Autonomous-Robotics-Carleton/arc-monorepo/firmware/README.md

# firmware

Code that runs on the car's microcontrollers.

| Folder | Target | RTOS | Decided in |
| --- | --- | --- | --- |
| `sync-mcu/` | STM32H723 on the sync board: time base, sensor timestamping, camera triggers, watchdog, safety envelope, the command and steering CAN buses, a telemetry UART from each motor controller, Ethernet to the Orin | Zephyr | ADR-0017, ADR-0021, ADR-0034 |
| `vesc/` | The four A50S motor controllers: stock VESC firmware plus the e-stop brake routine, UART telemetry and a speed limit | ChibiOS | ADR-0012, ADR-0033, ADR-0034 |

The steering controller (moteus-c1) runs mjbots' firmware, not ours. Its configuration (timeout mode, limits, belt ratio) will be kept here too (ADR-0019).

Safety functions live only on the sync MCU and the VESCs, never on the Orin (ADR-0017). Changes to them get extra review.

Each firmware builds for simulation, development hardware and the car from the same source (ADR-0028). For the VESC firmware, simulation means host unit tests of our additions, and development hardware is a spare A50S on stock firmware; the toolchains come in the dev container (ADR-0029). How it all fits: `systems/software/architecture.md`; what's being set up and in what order: `systems/software/setup-plan.md`.
