Autonomous-Robotics-Carleton/arc-monorepo/firmware/vesc/README.md

# vesc

Firmware for the four motor controllers: off-the-shelf Team Triforce A50S V2.3c boards on the lower deck (ADR-0034), built from upstream's `a50s_v23c_12s` target. Flash it with VESC Tool over USB; per-unit current calibration lives in the board's EEPROM and survives reflashing.

It's stock VESC firmware plus four additions:

- **E-stop brake routine** (ADR-0012, ICD-corner-connector): reads ESTOP on the Servo/PPM pin (PB6) with the MCU's pull-down, so an open line is an e-stop. While ESTOP is low it ignores every motor command (CAN, USB, apps), ramps brake current from 0 to the target over 150 ms (TBC) and holds it; the target, ~8 A (TBC), is worked out from the 5 m/s² deceleration (TBC, ADR-0052) and the car's mass, tyre, gearing and motor kV, all named constants in `arc/include/arc/estop.h`. Releasing ESTOP doesn't restart motion: the brake stays on until a fresh command arrives. The logic is in `arc/src/estop.c` with host tests; `arc/port/estop_vesc.c` runs it every millisecond on the controller. The PPM app and servo output must stay off (the routine takes the pin back if they claim it), and on the bench ESTOP has to be held high to drive or run motor detection. This is a safety function: it needs its own test cases, and every change gets a second reviewer. **Not safe on its own yet:** "a fresh command hands back control" relies on the sync MCU latching on every e-stop press and resuming only after the release, its power-on checks and the operator's re-arm, with zero commands first (owner decision; its ADR is in draft). That latch isn't implemented yet, so until it is, releasing ESTOP on a bench rig lets the motor resume on the next command it receives: bench-test with the wheel off the ground and the command source at zero.
- **Command timeout** (ADR-0035): no command for 150 ms (TBC) while driving brakes on the same ramp as the e-stop, ignoring commands until a fresh one arrives; a press takes over at any time. It replaces upstream's timeout (1000 ms, then 0 A: coasting), which can't act while the routine brakes. A command is anything that resets upstream's timeout: CAN on the car, and on a bench also USB and VESC Tool's keepalive, which keep the motor out of the timeout. Part of the e-stop routine (`arc/src/estop.c`), so the same safety function: `arc_estop_command_timeout()` is the `COMMAND_TIMEOUT` bit for the telemetry.
- **UART telemetry** (ADR-0024, ADR-0034, ICD-controller-telemetry): MAVLink 2 `ARC_MOTOR_STATUS` at 1 kHz, including a `state` field that reports braking on e-stop or command timeout (ADR-0035), and `ARC_LINK_STATUS` at 1 Hz (message set in `systems/icd/sync-link.xml`), on the A50S's UART (USART3, PB10/PB11) to the sync MCU at 2 Mbit/s (exact with 16× oversampling from its 42 MHz clock); motor commands stay on the classic CAN bus. Each frame is built from the latest motor-control values at send time, with `time_ns` in the controller's clock. The telemetry thread runs at high thread priority; motor control runs in the ADC interrupt, which preempts every thread, and RSK-12 tracks what's left of the risk. UART transfers are to be DMA-driven, which needs upstream's serial driver off USART3. The MAVLink code isn't generated into this firmware yet.
- **Speed limit** (ADR-0034): maximum eRPM ~75k (TBC), which keeps ≥ 10 control-loop samples per electrical cycle; stability up to it is checked on rig R2 (RSK-18). The firmware clamps the configured eRPM limits to it on every configuration change and timer tick, whatever VESC Tool or a configuration message sets. Upstream's eRPM limit is soft: it cuts back the motor current as the motor approaches the limit and truncates speed-mode setpoints. It doesn't brake, so it can't stop overspeed driven from outside (rolling downhill, being pushed). The bench sweep on rig R2 confirms how the motor behaves at the limit (RSK-18).

**Don't touch the USB, CAN or firmware-upload code.** The running firmware receives uploads, so a build that breaks them can only be recovered over SWD (RSK-20).

## Upstream and updates (ADR-0033)

Upstream `vedderb/bldc` is vendored into `bldc/` as a plain snapshot, at `release_7_00` (SQ-3). `UPSTREAM` records the repository, ref and commit it's based on. Our additions are modules in `arc/`; `bldc/` carries only the ordinary commits that join them to the build (ADR-0037): one line in `make/fw.mk` that includes `arc/arc.mk`, and the call sites, each marked with an `ARC` comment.

```bash
tools/vesc-upstream.sh import <ref>   # first import: done, at release_7_00 (SQ-3)
tools/vesc-upstream.sh update <ref>   # bring in upstream's changes, three-way, in a PR of its own
```

The script stages its result but doesn't commit it; on conflicts it lists the files and exits 2. It skips lispBM's tests, test reports, REPL, docs, examples, benchmarks, videos and mascot on every import and update. `VESC_UPSTREAM_URL` overrides the upstream repository.

**Licence:** everything under `firmware/vesc/` is GPL-3.0, under upstream's licence; the rest of the repo is MIT. Don't copy code from here into other parts of the repo.

## Layout

| Path | What |
| --- | --- |
| `bldc/` | Upstream VESC firmware, plus the hooks that join `arc/` to the build (marked `ARC`) |
| `arc/` | Our additions (e-stop and command timeout, UART telemetry, speed limit) as modules with host tests; `arc.mk` joins them to the firmware build. A module not implemented yet is a fail-safe stub |
| `UPSTREAM` | The upstream commit `bldc/` is based on |
| `motors/` | Each drive motor's detected configuration, by the label on the motor, and how to load it with VESC Tool after a corner swap (SYS-13) |

## Build and test

In the dev container (GCC 7 2018-q2, the compiler upstream expects):

```bash
npx nx build vesc   # bldc: make fw_a50s_v23c_12s -> bldc/build/a50s_v23c_12s/*.bin
npx nx test vesc    # arc/: host tests with CMake and CTest, then the coverage check
```

The host tests run under AddressSanitizer and UndefinedBehaviorSanitizer, so a memory error or undefined behaviour fails a test even when the value it checks comes out right (`-DARC_SANITIZE=OFF` to build without). They then run again instrumented for coverage, and `nx test vesc` fails unless every line and branch in `arc/src/` runs (proposed in #159, pending the team's minimum). The firmware hooks in `bldc/` aren't host code, so they aren't counted; the hook tests check they're still in place.

Upstream's Makefile warns that the ARM SDK isn't in `bldc/tools`: ignore it. The container's GCC is on `PATH`; don't run `make arm_sdk_install`, which downloads a second copy.

Flash the `.bin` with VESC Tool over USB, following [the flashing procedure](../../systems/tests/a50s-flashing.md): one controller at a time, with the configuration backed up and the e-stop checked again after each, and how to recover a controller over SWD.
