Autonomous-Robotics-Carleton/arc-monorepo/systems/architecture.md

# ARC 4WD Car: Architecture Overview (v1)

Rewritten 2026-10-03 from the original interface spec (Sep 23, 2026, @shrikar vempati). This is the narrative overview. The decisions and numbers live in `requirements/`, `adr/`, `icd/`, `bom/` and `budgets/`; where this page and those disagree, those win. The diagram version is the topology page (`topology.html`).

## What the car is

A 1/10-scale 4WD autonomy research platform: a sandbox where the team's engineers try ideas in software without building hardware first. Classical pipelines come first (state estimation, localization, planning, MPC), then learned and embodied-AI policies (VLAs). Hardware should never be the reason an experiment fails, and should never limit what software can try. Every sensor runs at its full useful rate, timestamped and logged (SYS-24). The accepted limits on v1 hardware are listed in `requirements/system.md`.

v1 is tightly integrated; modular hardware is a v2 goal. The car runs on an indoor school floor and is sized to the F1TENTH/Roboracer box (width 238–341 mm, length 454–654 mm), without following their single-motor, power-equivalence or head-to-head rules.

| Area | v1 | Decided in |
| --- | --- | --- |
| Drive | 4× Castle 1010-4400kV, one per wheel, two-stage gearbox, CVDs | ADR-0026 |
| Motor control | 4× A50S V2.3c (off the shelf, VESC firmware) on the lower deck | ADR-0034 |
| Steering | Gimbal brushless motor + belt, driven by a moteus-c1 | ADR-0019 |
| Compute | Jetson Orin NX 16GB on a fork of Antmicro's baseboard (v1.0: Orin Nano Super developer kit); JetPack 7.2.1, ROS 2 Jazzy | ADR-0010, ADR-0016, ADR-0025, ADR-0046 |
| Sync and sensor hub | STM32H723 on Zephyr: owns the time base, safety envelope and watchdog | ADR-0011, ADR-0017, ADR-0021, ADR-0034 |
| Power | 4S LiPo; power board with LV rails, monitoring and e-stop circuit; bus clamp | ADR-0012, `budgets/power-scenarios.md` |
| Ground link | Team router (GL.iNet Flint 3, 6 GHz), laptop gateway, button hotspot, service port | ADR-0015 |

**Builds (ADR-0046):** this overview describes the full design, v1.1. v1.0 is built first on the Orin Nano developer kit and a UST-20LX, with the stereo pair and a downward frame camera; see [builds](builds.md) for every difference.

**PCB packaging (ADR-0042):** the power and sync functions below share one [motherboard PCB](../hardware/motherboard/README.md); the Jetson carrier remains separate. References to power/sync boards describe those functional sections. The power-sync contract now covers internal PCB signals, with a future two-board split subject to review.

## Drive

**Corners.** Each corner is a motor and gearbox; we design its knuckle or upright, arms and mounts, and buy the shocks, CVDs and wheels (ADR-0040). Its motor controller sits on the lower deck (ADR-0034), and there's no corner module or corner sensor MCU (ADR-0006). The vehicle-state sensors sit on our own small boards with no MCU, assembled in house: ten AS5047P angle boards (four wheel, four suspension, two front knuckle), two ISM330DHCXTR IMU boards and five ToF boards (ADR-0045). They wire directly to the sync board (ADR-0008).

**Motor:** [Castle 1010-4400kV](https://www.powerhobby.com/products/castle-creations-060-0098-00-4-pole-sensored-brushless-motor-1010-4400kv), sensored, 2S–4S.

| Motor interface | Value |
| --- | --- |
| Can size | 28 mm dia × 58.4 mm |
| Mass | 146.5 g with wires |
| Shaft | 3.175 mm (1/8"), 15 mm long |
| Mount holes | M3 on 19 mm (also M2.5 on 14 and 16 mm) |
| Max speed | 80,000 rpm |

The motor mount clamps a 28 mm can on this bolt pattern, so any 28 mm motor drops in.

**Layout:** motors transverse (parallel to the axle), inboard, staggered fore and aft on each axle so two motors and gearboxes fit the width. Output reaches the wheel through a CVD.

**Gearbox:** two stages per corner.

- Stage 1 (swappable): hardened steel pinion into an off-the-shelf spur, mod 0.5, constant 80 total teeth, so every pair uses the same bearing bores and mesh.
- Stage 2 (fixed): about 4.5:1 to the wheel, steel spur gears (around 12/54). Not printed; this stage carries the highest torque. A belt is the fallback only if the motor stagger offset gets too large for gears.
- Bearing bores are held precisely (aluminium plate or press-fit inserts), not raw printed holes.

| Pinion/spur | Stage 1 | Overall | Approx. top speed | With the eRPM cap (ADR-0034) |
| --- | --- | --- | --- | --- |
| 14/66 | 4.71:1 | 21.2:1 | 12.3 m/s | 9.3 m/s |
| 16/64 | 4.00:1 | 18.0:1 | 14.5 m/s | 10.9 m/s |
| 18/62 | 3.44:1 | 15.5:1 | 16.9 m/s | 12.7 m/s |
| 20/60 | 3.00:1 | 13.5:1 | 19.4 m/s | 14.5 m/s |

Assumes 4S, about 50,000 rpm loaded and a 100 mm tyre (ADR-0040); a worn tyre is smaller and slower. The controllers cap the motor at ~37,500 rpm (~75k eRPM, TBC, ADR-0034), so the last column is the real top speed. **16/64 (18:1) is the baseline:** ~10.9 m/s at the cap, with the motor at ~83% of the cap at 9 m/s (RSK-18). 14/66 barely reaches 9 m/s. Front and rear may run different ratios on purpose. SYS-01 requires ≥ 9 m/s.

**Motor control:** four off-the-shelf A50S V2.3c controllers (35.5 × 21 × 13.8 mm, VESC firmware) on the lower deck, running our build of the vendored VESC firmware (ADR-0033, ADR-0034).

- Commands arrive over one classic CAN bus (1 Mbit/s, ADR-0009) using the stock VESC path.
- Full timestamped telemetry at ≥1 kHz uses four independent **2 Mbit/s 8N1 UARTs** from the A50S controllers to the H723 (ADR-0034). Firmware endpoints, clock alignment and loaded harness margins remain unqualified; see the [UART ICD](icd/controller-telemetry.md) and [readiness review](reviews/a50s-uart-readiness.md).
- A maximum-eRPM limit in each controller keeps the motors in the range where its control loop is stable.
- Each corner sends its motor phases and Hall sensor cable to the deck (ICD-corner-connector rev F).

## Steering

A gimbal-style brushless motor drives the steering through a ~4–6:1 belt (zero backlash), controlled by an mjbots moteus-c1 on its own CAN-FD bus (ADR-0019).

- Targets: lock to lock ≤ 0.1 s, ≥ 10 Hz bandwidth, ≥ 1.5 N·m, ≤ 0.1° backlash, angle and torque at ≥ 1 kHz.
- Absolute AS5047 encoders on **both** front knuckles give the real wheel angles, and are the actuator's absolute reference.
- Fallback actuator: an integrated CubeMars AK60-6-class unit.

## Power

The [updated EE sizing review](adr/0044-ee-sizing-after-custom-corners.md) uses the current main scenario and reopens dump-resistor sizing. Motor thermal and runtime qualification remain pending.

4S LiPo hardcase, charged off the car at the team's charging station (a separate system; the pack is the interface, ICD-battery-pack).

- **Motor path:** battery → loop key / anti-spark → the power board's switched motor bus (cut by the e-stop) → bus bar or heavy wire (E-45) → an XT30 at each motor controller on the deck, plus the switched steering output. The bus clamp board burns off regen spikes above full-pack voltage.
- **Power board:** LV rails (compute, sensor, 5 V / 3.3 V), with per-rail fuse, switch and current sense. It also carries:
  - battery V/I monitoring and **per-cell monitoring** through the balance lead (SYS-32)
  - wall (19 V) / battery ideal-diode OR-ing
  - regulators rated ≥ 30 V with TVS
  - the e-stop circuit
- **Low battery:** the lowest cell triggers a warning, then a clean Orin shutdown before cutoff (SYS-30). Voltage sag at peak current must never reset anything (SYS-31).
- **Interfaces / returns:** [power-rails](icd/power-rails.md), [power-sync-stack](icd/power-sync-stack.md) and [carrier-sync](icd/carrier-sync.md) are draft logical contracts. Proposed ADR-0041 records the grounding / isolation review; physical assignments and approvals are pending.
- **Sizing inputs:** `budgets/power.csv` and `budgets/power-scenarios.md`. The tires limit useful peak current (`budgets/power-scenarios.md`), not the old 120 A figure. Rail sizing is the EE's.

## Compute and software

- **v1.1: Orin NX 16GB** on a fork of Antmicro's open baseboard: four 22-pin CSI ports, a trigger connector to the sync board, a fixed compute-rail input, M.2 key M (swappable 4 TB NVMe) and key E (MT7922 Wi-Fi), GbE, and expansion GPIO for the hotspot button. Optional Intel i210/i226 NIC if a PCIe lane is free (ADR-0021).
- **JetPack 7.2.1** (Ubuntu 24.04, kernel 6.8), **ROS 2 Jazzy**, **PREEMPT_RT**. Platform software runs on reserved cores; experiments run in containers with resource limits (ADR-0016, SYS-21).
- **Layered control:** learned policies send targets to the classical controller. The safety envelope is enforced on the sync MCU (SYS-22).
- **v1.0:** the Orin Nano Super developer kit from the Traxxas car, on its own carrier: two CSI connectors (stereo and the downward B0223), a 9–20 V barrel input, the 40-pin header for PPS and the buttons ([builds](builds.md)). It takes the NX module too, so the NX can come up on it before the carrier is built.

## Sync and sensing

The sync MCU (STM32H723, Zephyr) owns the car's time base. It timestamps sensors at the pin, triggers the cameras, runs the heartbeat watchdog and safety envelope, and uses classic command CAN, four A50S telemetry UARTs and the separate moteus steering FD link (ADR-0034). µs-critical sensors are timestamped in its clock; the Orin follows in software to ≤ 1 ms (ADR-0021, SYS-07 ≤ 10 µs).

| Sensor | Part | Rate | Connects to |
| --- | --- | --- | --- |
| 2D LiDAR | Hokuyo UST-10LX (10 m, 0.25°); v1.0: UST-20LX on loan | 40 Hz | Ethernet switch |
| Forward stereo | Arducam AR0234 (global shutter) | Native | CSI 1, triggered (v1.0: dev kit CAM1) |
| Side/rear cameras | Arducam quad OV9281 (v1.1) | Native | CSI 2, triggered |
| Forward event camera | Prophesee GenX320 (v1.1) | Continuous | CSI 3, Trigger In |
| Ground-speed camera | Second GenX320, pointing down, three lighting modes (cross-polarized LED, grazing LED, Class 1 laser speckle). v1.0: Arducam B0223 OV9281 frame camera and the two LED modes (ADR-0046) | Continuous (v1.0: up to 240 fps) | CSI 4, Trigger In (ADR-0014); v1.0: dev kit CAM0, frame trigger |
| IMU at CG | ST ISM330DHCXTR (industrial grade) on our IMU board (ADR-0045) | ≥ 4 kHz | Sync SPI + DRDY |
| IMU, front axle | ST ISM330DHCXTR, same board design (ADR-0045) | ≥ 4 kHz | Sync SPI + DRDY |
| Wheel encoders ×4 | AS5047 on the wheel output shaft | 2 kHz | Sync SPI |
| Suspension angle ×4 | AS5047-family, contactless | 2 kHz | Sync SPI |
| Steering knuckle ×2 | AS5047 | 2 kHz | Sync SPI |
| Ride height ×5 | ToF on our own boards (4 corners + 1 for ground-speed scale; ADR-0045) | Native | Sync I2C + mux |
| Cell voltages ×4 | Motherboard cell monitor | ≥ 100 Hz | Internal power/sync signals (ADR-0042) |
| Motor/FET temperature, currents | Controller telemetry | ≥ 1 kHz | Four 2 Mbit/s UARTs (ADR-0034) |

Latency from sample to the Orin is ≤ 2 ms for sync-board sensors and VESC telemetry (SYS-29, `budgets/latency.csv`).

[Sensor qualification](bom/sensor-candidate-review.md) still needs installed timing, calibration, vibration and slip-estimation evidence. ELPM remains an unselected suspension alternative. [PCB estimate](bom/jlc-pcba-cost-estimate.md) retains the 30% allowance. The [total electrical estimate](bom/total-electrical-cost.md) adds bought hardware and estimated HST.

## Communication

Wi-Fi is the only wireless link (ADR-0005). The car joins the team's Flint 3 router on 6 GHz. The operator laptop is wired to the router and keeps its own Wi-Fi for internet. Only the car gets a gateway, through the laptop or the router's phone tether. A button on the car turns it into its own 5 GHz hotspot, and a chassis Ethernet port always works (ADR-0015, SYS-26 to SYS-28). Teleop is a fixed-rate UDP stream with priority marking: ≤ 20 ms p95 (SYS-11).

## Stopping

| Layer | Trigger | Runs on | Behaviour |
| --- | --- | --- | --- |
| Heartbeat watchdog | Laptop heartbeat lost (~150 ms); the Orin forwards it, so a hung Orin trips it too | Sync MCU | Rolls ≤ 2 m, then the same brake ramp (SYS-04) |
| Any-corner stop | One corner silent for 5 ms on its telemetry link or ~60 ms on the command bus (TBC), braking on its own (e-stop or command timeout) or faulted; or the command bus failing | Sync MCU | All four corners brake within 20 ms (SYS-25, ADR-0035) |
| Sync MCU silent | No command for 150 ms (TBC) | Each motor controller | Brakes on the e-stop ramp (ADR-0035) |
| Steering lost | No steering reply for 5 ms (TBC), a steering fault, steering-bus bus-off, or an untrusted steering angle | Sync MCU | All four corners brake within 20 ms (SYS-25, ADR-0038); no drive until steering is healthy |
| Fault-stop reset | After any SYS-25 stop: the e-stop button on the car pressed past T and released, the power-on checks pass, and the operator re-arms from the laptop | Sync MCU | Drive allowed again, from zero commands, with the envelope back at 3 m/s; some faults need a full restart and an inspection (ADR-0039) |
| Physical e-stop | Button, or the e-stop circuit losing power. A broken or unplugged ESTOP wire brakes that controller, which reports it, and the sync MCU stops the car through SYS-25, without the hardware cut (ICD-corner-connector, ADR-0035) | Controller firmware + power-board timer | Ramped brake (~5 m/s²), motor-bus power cut at T (TBC 2.4 s, after the ~1.9 s stop); steering returns to centre, cut ~1 s later (ADR-0012, ADR-0019) |
| Command timeout | Corners stop hearing commands | Controller (VESC) / moteus firmware | Brake / hold |

## Harness

The [proposed wiring diagram and cable budget](bom/motherboard-wiring.md) separates remote sensor looms, power, bought A50S controllers and the Jetson carrier. The angle, IMU and ToF boards total seventeen sensor runs / 111 minimum conductors, including seventeen spare conductors (TBC wiring proposal, ADR-0045). All seventeen boards are assembled in house; their 2-layer implementations, connector contacts and the complete motherboard wire total remain TBC/TBD.

Every connection locks; every run carries a spare conductor; every wire is labelled with its schematic net name; strain relief at every board entry. JST-GH for signal; the controllers' own connectors (XT30, MR30, Pico-Clasp) on the deck. Twisted pairs for CAN buses; four A50S UART signal/reference cable runs, routed away from motor phase leads (ADR-0034); Hall cables too. Command-bus terminators sit at the sync board and the far end of the trunk.

## Mechanical

Mechanical design is at the block layout (`mechanical/layout-brief.md`, `mechanical/cad-workflow.md`). Constraints from the original spec and the decisions since:

- **Wheels:** ~Ø100 × 42 mm belted on-road tyres on a 17 mm hex (ADR-0040). Tire compound for tile is TBD.
- **Size:** F1TENTH/Roboracer box: width 238–341 mm, length 454–654 mm (SYS-02). The overall length must reach 454 mm (RSK-16).
- **Battery bay:** placed first in the layout, low and central, sized to a 1/10 hardcase; ~5,000 mAh 4S is the starting point.
- **Mass:** heavy parts (battery, motors, motor controllers) on the lower deck. The upper deck carries a hole grid for sensors.
- **Front corners must fit:** staggered motors, both gear stages, CVDs, wheel encoders, suspension sensors, knuckle encoders and the steering actuator, at full lock and full bump (RSK-04).
- **Underfloor:** reserve a flat volume for the active-aero suction fan, plus the ground-speed camera's floor window and shroud, and the 4 corner ToF sensors. The dead-wheel pod's space is reserved as the ground-speed fallback.
- **Clear sightlines:** LiDAR with a clear 270°+ field of view and a crash guard; rigid stereo bar; positions for side/rear and event cameras; Wi-Fi antennas high and clear of carbon-filled parts.
- **Mounting:** IMU at the CG and the second IMU near the front axle, both vibration-isolated.
- **Access:** service port, hotspot button and e-stop button on the chassis.
- **Cooling:** for the Orin, and airflow over the motor controllers on the deck (the per-corner current in `budgets/power-scenarios.md` against 40 A continuous with the heatsink; airflow is sized once the deck is modelled).
- **Reserved:** an encoder pocket behind each motor for a future rear-shaft motor.

## Where to look next

- Open questions per board: `handoff/electrical.md`
- Risks: `risks.md`
- Verification: `verification/plan.md`
