Autonomous-Robotics-Carleton/arc-monorepo/apps/docs/content/docs/car/topology.mdx

---
title: Topology
description: Interface topology, sync board I/O and the stop sequence, as one diagram.
full: true
---

import { HtmlEmbed } from '@/components/HtmlEmbed';

[Open full screen](/embed/topology) · Source: [`systems/topology.html`](../../../../../systems/topology.html)

<HtmlEmbed src="/embed/topology" title="ARC car interface topology" />
