Autonomous-Robotics-Carleton/arc-monorepo/systems/risks.md

# Risk Register
Ranked by how much of the design the risk could force us to redo. Retire risks from the top. Each risk is closed by its spike test, not by discussion.
| Rank | ID | Risk | If it bites | Spike test that retires it | Owner | Status |
| --- | --- | --- | --- | --- | --- | --- |
| 1 | RSK-01 | Antmicro carrier fork (4× 22-pin CSI, new power input, trigger routing) plus our own camera device-tree and driver work | No compute, no cameras: blocks autonomy | Bring up each camera kit on the Orin Nano dev kit with the NX module first; get a quote and DFM review for the forked board before layout freeze; confirm Arducam (AR0234, OV9281) and Prophesee (GenX320) drivers exist for JetPack 7.2 (ADR-0016), otherwise fall back to JetPack 6.2.x. Ask each GenX320 module vendor: (1) does it plug into a Jetson 22-pin CSI port, (2) is there a JetPack 7.2 driver, (3) is the sensor's Trigger In pin broken out (ADR-0021) | TBD | Open |
| 2 | RSK-02 | Custom VESC 6 derived single-motor corner board (new layout, mount-cooled FETs, e-stop enable input not in stock VESC) | No drive | Run a stock VESC 6 (or a clone) on a 1010 motor on the bench with the target gear load; validate thermals with the FETs bolted to an aluminum plate | TBD | Closed: retired by ADR-0034 (off-the-shelf A50S controllers; no custom controller board) |
| 3 | RSK-03 | The steering CAN-FD bus (sync board + one moteus-c1, 5 Mbit/s data phase; ADR-0019, ADR-0036) fails from ringing, EMI from the steering motor and the drive phase leads, or ground shift. Judgment: less likely than for the drive buses it first covered (two nodes, a short run, ~12% load) | Steering errors and resends; at worst no steering: the car stops (SYS-25, ADR-0038) | Bench: a NUCLEO-H723ZG with an SO-8 FD transceiver and a moteus-c1, on the car's harness length, beside a running corner on rig R2 with its phase leads along the harness: ≥ 1 h at 5 Mbit/s with full steering traffic, zero error frames; then a ground offset. Mitigated by design (ADR-0036): discrete transceiver with SIC drop-in, rework footprints, a lower data rate (TBC) | TBD | Open: restated 2026-10-08 for the steering bus. It first covered the two drive telemetry buses, removed by ADR-0034 (`tests/rsk-03-canfd-bench.md`, retired) |
| 4 | RSK-04 | Front corner doesn't fit: staggered motor, two gear stages, CVD and encoder at full lock and full bump | Changes wheelbase, track or gearbox | CAD block layout of one front corner with real envelopes | TBD | Open |
| 5 | RSK-05 | The corner connector has no e-stop enable line and no spare pin, and a daisy-chained CAN-FD trunk needs in and out pins at every corner | E-stop can't reach corner boards in hardware; connector redesign after harness build | Close in `icd/corner-connector.md` before any corner board layout | TBD | Closed: ADR-0034 moves the controllers to the deck, so the e-stop line no longer crosses the corner connector |
| 6 | RSK-06 | Regulators rated "≥ 20 V" against a 19 V wall brick and LiPo hot-plug transients | Power board failure takes the Orin with it | Analysis: worst-case input including plug-in transients; pick parts rated ≥ 30 V with TVS | TBD | Open |
| 7 | RSK-07 | The downward event camera finds too little texture on the school floor (low-contrast VCT, wax glare), or the ToF ride-height sensors misread glossy tile | No direct ground velocity or sideslip (SYS-10); no ride-height or aero baseline data (ADR-0007) | Optional phone test (`tests/ground-speed-phone-test.md`). Mitigated by design (ADR-0014): cross-polarized, grazing and Class 1 laser-speckle lighting, adjustable contrast threshold. Fallback: dead-wheel pod (space reserved) | TBD | Open, mitigated |
| 8 | RSK-08 | Orin NX overheats in the printed enclosure under sustained load | Throttling breaks SYS-08 | Run the target workload in a mock enclosure, log temps and clocks | TBD | Open |
| 9 | RSK-09 | Wi-Fi drops longer than the watchdog timeout cause frequent false stops | Unusable test sessions | Mitigated by ADR-0015: dedicated team router on a clean 6 GHz channel, mounted high; UDP teleop with DSCP EF / WMM voice priority; power saving off; bulk transfers only while parked. Verify: drive the track and log heartbeat gaps to set the timeout | TBD | Open, mitigated |
| 10 | RSK-10 | Hokuyo UST-10LX sourcing (price, lead time) | LiDAR swap; ADR-0001 reopens | Get quotes now | TBD | Open |
| 11 | RSK-11 | E-stop braking depends on the controller firmware; a hung controller coasts until the power board removes motor-bus power (ADR-0034) | One corner doesn't brake on e-stop; asymmetric braking yaws the car | HIL test of the e-stop routine on the bench (wheel off the ground, then on the track at low speed); a firmware watchdog on the VESC; test braking with one corner disabled to see how the car behaves | TBD | Open; with ADR-0034 the hardware cut is the power board removing motor-bus power |
| 12 | RSK-12 | The added telemetry firmware on the motor controller (UART with DMA, ADR-0034; was SPI to a CAN-FD controller) disturbs the motor control loop or drops frames | Motor control glitches, or gaps in telemetry | Bench: run the motor at full load with telemetry at 1 kHz; log control-loop timing and telemetry sequence numbers; fault-inject UART errors | TBD | Open (now the UART telemetry path, ADR-0034) |
| 13 | RSK-13 | No spare CSI port after ADR-0014 (all four used) | A new camera needs a CSI multiplexer or the v2 carrier | Accept for v1; check CSI multiplexer options before the carrier layout freezes | TBD | Accepted |
| 14 | RSK-14 | The MT7922 Wi-Fi driver isn't available on the JetPack kernel | No 6 GHz link or 5 GHz button hotspot | Closed by ADR-0016: JetPack 7.2.1 uses kernel 6.8, where the MT7922 driver is in mainline. Reopens only if RSK-01 forces JetPack 6.2.x | — | Closed |
| 15 | RSK-15 | The Orin NX's Ethernet doesn't support PTP hardware timestamping | Clock alignment through the Orin falls back to tens of µs | **Realized (checked 2026-10-03):** NVIDIA states PTP isn't supported on Orin NX; the Orin Nano/NX Ethernet is a Realtek RTL8111 with no PTP clock (`ethtool -T`: PTP Hardware Clock: none). Resolved by ADR-0021: timestamp all µs-critical sensors in the sync MCU's clock (triggers + sequence numbers) and sync the Orin by software to ≤ 1 ms; optional Intel i210/i226 NIC on the carrier for hardware PTP | — | Realized; resolved by design (ADR-0021) |
| 16 | RSK-16 | The car comes in under F1TENTH's 454 mm minimum length (too short a wheelbase for the wheels and bodywork) | Not eligible to race until fixed | Check overall length in the CAD block layout; fixes: longer wheelbase, or front/rear bumpers and body that count toward overall length | TBD | Open |
| 17 | RSK-17 | The printed PAHT-CF lower tub flexes, creeps at bolted joints, or softens near heat | Drivetrain misalignment, loosening joints, handling changes | Ribbed tub design; aluminium for precision and heat; heat-set inserts; print a test section and check stiffness by hand-loading and a twist test before the full deck; recheck joints after runs | TBD | Open |
| 18 | RSK-18 | The A50S's motor control is rough or unstable near its ~75k (TBC) eRPM limit (two low-side shunts, 12.5 kHz control loop at default settings; ADR-0034) | Top speed below 9 m/s, or torque ripple at speed | Analysis in ADR-0034 (≥ 10 loop samples per electrical cycle at 9 m/s); on rig R2, sweep to the eRPM limit under load and log current ripple. Mitigations: a lower gear ratio (lower motor speed for the same car speed, more current), or the VESC 6 MkVI. Weak evidence for: Triforce lists the TP2040, a small high-kV inrunner, among tested motors (speeds not stated) | TBD | Open |
| 19 | RSK-19 | A50S supply: one small vendor (Team Triforce, UK), no datasheet, possibly slow to respond or ship; the board could be revised | No controllers in time, or a revised board that differs from the upstream hardware config | Order all units plus spares (4 + 2) early in the single order; the VESC 6 MkVI drops into the same design (ADR-0034) | TBD | Open |
| 20 | RSK-20 | A controller firmware build that breaks USB and CAN can't be fixed by a normal upload: in VESC firmware the running application receives uploads | A bricked controller until it's reflashed over SWD | SWD is on the A50S's 20-pin connector (Triforce pinout), so recovery is an ST-Link through the harness. Leave the upload and communication paths untouched in our firmware; flash a spare first | TBD | Mitigated: SWD broken out on the signal connector |
| 21 | RSK-21 | The drive's gearing and power figures assume a 62 mm wheel and ~3.5 kg (ADR-0034, `budgets/power-scenarios.md`); the car is expected at 4 kg or more on ~100 mm wheels (ADR-0040) | The 13.5:1 ratio misses SYS-01's margin or the motors' torque, or the per-corner current, the motor-bus parts or the battery capacity are undersized | Recompute the ratio, the eRPM margin on SYS-01, the current per corner at 1 g and the battery capacity for the new wheel diameter and the mass budget; stage 1 is swappable (ADR-0026), so the ratio can change without redesign | TBD | Open: `power-scenarios.md` and `architecture.md` redone for 100 mm and 4–5 kg (2026-10-09); closes when the mass budget replaces the guess |
| 22 | RSK-22 | The corners' machined parts (front knuckles, rear uprights, arms, mounts; ADR-0040) are wrong on arrival: a bore, a pick-up point or a clearance at full lock or full bump | A corner can't be built or doesn't meet ADR-0019's backlash, and fixing it needs a second order | The fab gate (`reviews/fab-gate.md`) for every machined corner part: fit at full lock, full bump and droop with the bought shocks, CVDs and wheels modelled from measured or vendor dimensions; standard bearing fits; load cases for crash and drive torque. Print each part in-house and assemble a printed corner against the bought parts' models before releasing the drawings | TBD | Open |
