Autonomous-Robotics-Carleton/arc-monorepo/(list of files, drawings)

Other design files:
hardware/motherboard/altium/02-Power-Rails.SchDoc
hardware/motherboard/altium/03-Drive-Steering-Power.SchDoc
hardware/motherboard/altium/09-Drive-CAN-UART.SchDoc
hardware/motherboard/altium/14-Lighting-Status-Controls.SchDoc
hardware/sensor-boards/angle/altium/ARC-Sensor-Angle-AS5047P.PrjPcb
hardware/sensor-boards/imu/altium/IMU-Sensor.SchDoc
hardware/sensor-boards/tof/altium/ARC-Sensor-ToF.PrjPcb
