Autonomous-Robotics-Carleton/arc-monorepo/ros/src/arc_backend_car/include/arc_mavlink/arc_sync_link/version.h

/** @file
 *  @brief MAVLink comm protocol built from arc_sync_link.xml
 *  @see http://mavlink.org
 */
#pragma once
 
#ifndef MAVLINK_VERSION_H
#define MAVLINK_VERSION_H

#define MAVLINK_BUILD_DATE "see systems/icd/sync-link.xml"
#define MAVLINK_WIRE_PROTOCOL_VERSION "2.0"
#define MAVLINK_MAX_DIALECT_PAYLOAD_SIZE 47
 
#endif // MAVLINK_VERSION_H
