Autonomous-Robotics-Carleton/arc-monorepo/(commit log)

2026-10-03 docs(systems): add requirements, ADRs, ICDs and risk register
    Move the car interface spec to systems/architecture.md as the overview,
    and add the systems engineering scaffold around it: draft system
    requirements, a ranked risk register, ADRs 0001-0009, the corner
    connector ICD (rev B), the fab gate checklist and budget plan.
    Decisions recorded: no corner module or sensor node in v1 (custom
    VESC 6 board only), tire temperature dropped, four corner ride-height
    sensors kept, encoders and pots wired to the sync board, and a single
    classic CAN bus.
2026-10-03 docs(systems): charging is a separate station system; add battery-pack ICD
2026-10-03 docs(systems): add functional electrical BOM with sync MCU I/O tally; expand RSK-07
2026-10-03 docs(systems): record optical ground-speed sensor as an open question with candidate findings
2026-10-03 docs(systems): set SYS-06, add SYS-24 full-rate rule, record VESC telemetry link as open ADR-0011
2026-10-03 docs(systems): e-stop as controlled braked stop (ADR-0012), SYS-18 reliability goal with FRACAS
2026-10-03 docs(systems): SYS-04 limits rolling before brake onset to 2 m
2026-10-03 docs(systems): lock in VESC telemetry on two CAN-FD buses (ADR-0011), connector rev C, SYS-25, bus-load budget
    [bus-load.csv]
2026-10-03 docs(systems): fix VESC connections in BOM
2026-10-03 docs(systems): ADR-0013 CAN-FD physical layer, connector rev D, RSK-03 bench test procedure
2026-10-03 docs(systems): ADR-0014 ground speed via downward event camera with three lighting modes; phone floor test
2026-10-03 docs(systems): ADR-0015 ground link with team router, laptop gateway and button hotspot; SYS-26 to SYS-28; drop ExpressLRS
2026-10-03 docs(systems): first-pass v1 cost budget with ranges and optional upgrades
    [cost.csv]
2026-10-03 docs(systems): navigation-grade CG IMU, magnetic suspension sensors, SYS-29 latency requirement and latency budget
    [cost.csv, latency.csv]
2026-10-03 docs(systems): ADR-0018 VESC-driven steering actuator with return-to-centre e-stop; drop servo rail; command bus budget
    [bus-load.csv]
2026-10-03 docs(systems): ADR-0019 steering on moteus-c1 with dedicated CAN-FD bus, CubeMars AK fallback; supersede ADR-0018
    [bus-load.csv, cost.csv]
2026-10-03 docs(systems): point BOM steering references at ADR-0019
2026-10-03 docs(systems): second steering knuckle encoder so both front wheel angles are measured
    [cost.csv, latency.csv]
2026-10-03 docs(systems): power loads and scenarios for the EE, SYS-30/31, electrical handoff
    [power.csv]
2026-10-03 docs(systems): per-cell battery monitoring (SYS-32, E-46)
    [power.csv]
2026-10-03 docs(systems): set SYS-07/08/11/22/25 to tightened values; ADR-0020 PTP time sync with PTP-aware switch; RSK-15
    [cost.csv]
2026-10-03 docs(systems): ADR-0021 time sync in the sync MCU's clock (supersedes ADR-0020); GenX320 Trigger In; vendor questions on RSK-01
    [cost.csv]
2026-10-03 docs(systems): rewrite architecture.md as the current overview; add topology page source
2026-10-03 docs(systems): mechanical layout brief for the CAD block layout
2026-10-03 docs(systems): mechanical decisions M1, M4 (printed CF-nylon tub + aluminium plates), M5; RSK-17
2026-10-03 docs(systems): PAHT-CF lower tub for now; mechanical open questions (printers, ride height, aero, crash)
2026-10-03 chore: add top-level folders for car code, hardware and platform
    ros/, firmware/ (sync-mcu, vesc), hardware/, platform/, tools/ and libs/,
    each with a README saying what goes there and which ADRs and SYS
    requirements it implements. No code yet. Root README lists the folders.
2026-10-03 chore(github): PR template, issue forms and CODEOWNERS for the car project
    - PR template asks for what/why, the SYS/ADR/ICD/RSK IDs it traces to,
    testing, and the systems/ rules (ADR for requirement changes, both-side
    ICD sign-off, extra review for safety functions).
    - Issue forms replace the generic templates: Failure report (FRACAS,
    SYS-18), Bug, Proposal. Security reports link to the security policy.
    - CODEOWNERS requests review from the maintainer on every PR.
2026-10-03 Shrikarv/repo skeleton (#50)
    * chore: post-rename and ownership cleanup
    - Point repo links at arc-monorepo (renamed from 2026); GHCR image name unchanged
    - Untrack .DS_Store
    - Remove FUNDING.yml
    - Auto-assign new issues to HalfPast9
    - Drop root package.json scripts that duplicated the Nx targets
    * chore: add top-level folders for car code, hardware and platform
    * build(nx): register systems, ros and sync-mcu projects; add systems:check
    - systems:check (tools/check-systems.mjs) fa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
2026-10-03 docs(site): render docs from where they live in the repo
    The site now reads pages from several places and mounts each at its
    place in the sidebar (lib/source.ts):
    - apps/web/docs/ (website docs, moved from the docs site) -> Handbook / Club website
    - platform/dev-kit/ (Orin Nano dev-kit notes, moved) -> Handbook / Orin dev kit
    - CONTRIBUTING.md -> Handbook / Contributing
    - systems/README.md -> How these docs work
    Markdown files keep their # heading for GitHub; the site drops it and
    uses its text as the title (exported at compile time, so the server
    never reads source files). Relative links are written as fi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
2026-10-03 docs(site): add The car section, rendered from systems/
    All of systems/ (except its README, already "How these docs work", and
    the ADR template) renders under /docs/car, with URLs mirroring the repo
    paths, e.g. /docs/car/adr/0012-estop-controlled-braking. The
    architecture overview is the section's landing page and folder READMEs
    are folder index pages. Sidebar order and section names live in
    lib/source.ts so systems/ holds no site config.
    The topology diagram (systems/topology.html) is served from a route
    prerendered at build and embedded on /docs/car/topology; the embed
    grows to fit and follows the site's light/dark toggle.
    Links into systems/ elsewhere (e.g. on the Welcome page) now reso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
2026-10-03 feat(systems-model): parse systems/ and check it for consistency
    libs/systems-model reads systems/ into a model: every ID's definition
    (SYS and LIM in requirements/system.md, RSK in risks.md, E in
    bom/electrical.md, one file per ADR), every reference to an ID, and each
    ADR's header fields and supersession. It's plain TypeScript that Node 22
    runs directly, so there's no build step.
    nx check systems now uses it and fails on:
    - relative links to missing files (as before)
    - IDs that are mentioned but not defined, or defined twice
    - ADRs missing Status, Date, Deciders or Traces to
    - supersession recorded on only one side
    - adr/README.md missing an ADR, or disagreeing with its status
    - live requi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
    [pnpm-lock.yaml]
2026-10-03 feat(systems-model): parse budget CSVs and check the IDs in them
    parseCsv handles quoted fields (commas, newlines, doubled quotes). The
    model lists systems/ CSVs as data files and scans them for ID
    references, so an unknown E-nn in power.csv fails the check like one in
    Markdown would.
2026-10-03 build(docs): bundle systems-model; production server skips fumadocs-mdx
    - transpilePackages bundles @arc/systems-model (TypeScript source) into
    the app.
    - next start no longer applies the fumadocs-mdx plugin. It recompiled
    source.config.ts on every start, which needs sources the runtime image
    doesn't have (and caused the earlier .source/ permission crash), so
    the .source/ workaround is gone.
    - Docker: the deps stage installs the workspace library and skips the
    docs postinstall, which next build reruns anyway; the runtime files
    belong to the nextjs user so Next can cache 404 pages.
2026-10-03 feat(docs): link every ID to its definition; GitHub alerts as callouts
    A remark plugin links each mention of SYS-nn, LIM-nn, RSK-nn, E-nn and
    ADR-nnnn to where it's defined, with the definition as the tooltip.
    Defining table rows get anchors (#sys-04), so links land on the exact
    requirement, limit, risk or BOM item. It uses @arc/systems-model, so the
    site and nx check systems agree on what an ID is.
    GitHub alerts (> [!NOTE], > [!WARNING], ...) in Markdown files render as
    callouts on the site, and natively on GitHub, so Markdown needs no JSX.
2026-10-03 docs(systems): bring the electrical BOM up to date with later decisions
    The BOM was written on 2026-10-02 and has fallen behind the power
    scenarios, the handoff and ADRs since.
    - E-30 connected to E-60, which never existed (likely the corner sensor
    node ADR-0006 removed). Now lists what it actually connects to:
    steering bus (E-31), stacking header (E-41), camera triggers,
    lighting (E-29), LEDs (E-33).
    - E-40: peak ~40-45 A (grip-limited, per power-scenarios.md), not the
    ~120 A motor figure; ~5,000 mAh starting point; balance lead to E-46.
    - E-41: decided behaviour from the handoff and power scenarios (switched
    steering output with delayed cut, cell monitor, reverse polarity, sag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
    [cost.csv]
2026-10-03 fix(docs): redirect / to /docs in config, not by rendering a page
    The (home) route rendered a layout and then redirected mid-render.
    A config redirect answers before any rendering. It's a 307, not
    permanent, so / can become a landing page later. The logo links to
    /docs directly.
2026-10-03 Shrikarv/systems model (#54)
    * docs(site): add The car section, rendered from systems/
    Links into systems/ elsewhere (e.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
2026-10-03 fix(docs): undo the stale re-apply from #54
    PR #54 was squash-merged after its branch had already landed through
    rebased commits, and after GitHub's "Update branch" merged an older
    main into it. The squash re-applied that stale state on top of the
    dev-server fix (174255f):
    - lib/source.ts declared carPath, carSidebar and carMeta twice, so the
    docs build failed (CI red on main at ad27137)
    - systems/README.md was excluded from the systems collection again and
    no longer mounted anywhere, dropping "How these docs work"
    This restores both files to 012535c, the last green main.
2026-10-03 feat(systems-model): ID index and a command-line lookup
    idIndex lists every defined ID with its title, status, where it's
    defined (path:line) and which files mention it. tools/systems-ids.mts
    prints it as JSON for given IDs or kinds, so agents and people can look
    up SYS-04 without searching:
    node tools/systems-ids.mts SYS-04 ADR-0012
    node tools/systems-ids.mts RSK
2026-10-03 ci: move actions to their current majors (Node 24)
    GitHub is forcing Node 20 actions onto Node 24 and warns about each.
    checkout v7, setup-node v7, pnpm/action-setup v6, nx-set-shas v5,
    docker login v4 and build-push v7, http-request v2: same inputs.
    proof-html v2 renames url_ignore to ignore_url and adds an HTML
    validator (topology.html passes it as of the previous commit).
2026-10-03 docs(systems): recommend answers to the three open electrical questions
    Proposed, not accepted: these are recommendations for the EE and team to
    review, and each ADR says so up front.
    - ADR-0022: power-board data reaches the sync MCU over a dedicated I2C
    bus from monitor ICs, with fault pins as interrupts and analog battery
    V/I as a rework fallback; low-battery shutdown is two-tier (sync MCU
    warns and requests the Orin shutdown, power board cuts the compute
    rail after halt and has its own undervoltage backstop for the pack).
    - ADR-0023: no i210/i226 network card on the v1 carrier; the sync MCU
    stays on the switch.
    The handoff and the BOM I/O tally keep the questions open and poin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
2026-10-03 docs(systems): fix two stale entries
    - adr/README.md listed PPS vs PTP time sync as still to record;
    ADR-0021 decided it.
    - budgets/latency.csv still described the steering actuator as a hobby
    servo. It's now the moteus-c1 from ADR-0019: a telemetry row on the
    same path as VESC telemetry, and an actuation row with ADR-0019's
    targets.
    [latency.csv]
2026-10-04 docs(systems): meet SYS-29 by firmware; measure it at the driver process, p99
    The latency budget gave VESC telemetry 1.5-2.5 ms against SYS-29's
    2 ms. Broken down, the two largest terms were firmware assumptions: a
    frame up to one period stale, and the sync MCU batching every 1 ms. The
    stock VESC isn't the limit (its status rate goes to 10 kHz).
    ADR-0024 (amends ADR-0011):
    - VESC telemetry frames are stamped at sampling; the telemetry thread
    runs at high thread priority (motor control is safe in the ADC
    interrupt); the sync MCU forwards every sample within 0.25 ms over UDP
    - SYS-29 is measured to the sync-MCU driver process on the Orin, p99,
    and covers steering telemetry; delivery to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
    [latency.csv]
2026-10-04 docs(systems): backfill ADR-0025 (carrier fork) and ADR-0026 (motor layout)
    Both decisions date from the original spec and were listed in the ADR
    index as still to record. Context, decision and consequences come from
    the current docs; the options and criteria are drafted from them and
    marked for the decider to confirm or correct.
    - ADR-0025: the Orin carrier is a fork of Antmicro's open Jetson
    baseboard (four triggered CSI ports, compute-rail power, M.2 for NVMe
    and Wi-Fi). Notes it's RSK-01 and that its fallback is undecided.
    - ADR-0026: one motor per wheel, transverse, inboard, staggered fore and
    aft (RSK-04). Notes a requirement gap: nothing asks for independent
    per-wheel torque,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
2026-10-08 docs(systems): set up the mechanical design workflow
    - mechanical/cad-workflow.md: how the team works in Fusion 360: hub
    structure (one design per subsystem, referenced into a top-level
    assembly), shared dimensions as user parameters (so M2 and M3 stay
    open), naming, the four phases, and the release process.
    - bom/mechanical.md: functional BOM seeded from the architecture, ADRs
    and layout brief: suspension (TBD, MQ-5), drivetrain, steering
    mechanics, machined aluminium, printed parts, fasteners.
    - budgets/mass.csv: item list for SYS-16; masses and positions come
    from the block layout.
    - ICD-corner-mechanical and ICD-deck-grid: outlines of what each
    interface must fix, all value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
    [mass.csv]
2026-10-08 docs(systems): recommend a suspension family (ADR-0027, Proposed)
    Answers MQ-5 as a recommendation for the mechanical team: suspension,
    steering and wheel parts from a competition 1/10 touring car (the XRAY
    X4 family), with crash spares in the order and Tamiya TB-05/TRF as the
    fallback. The deciding criteria are individually sold corner parts
    (CVDs and the output joint, fed from our own gearbox) and precision for
    ADR-0019's backlash target; track and wheelbase come from our tub.
    Budget TT-02 parts are ruled out by play; the Traxxas 4-Tec 3.0 by its
    54 mm wheels. Prices, model and Canadian availability are to be checked
    before acceptance.
2026-10-08 docs(systems): software goals, decisions and setup plan
    The repo is being set up for software, firmware first. This records the
    goals and the decisions before any scaffolding:
    - SYS-33: every software component builds and runs from the same source
    on simulation, development hardware and the car (hardware arrives in
    one order, so software can't wait for it)
    - ADR-0028: targets per component (Zephyr native_sim / NUCLEO-H723ZG /
    our board; host tests / stock VESC 6 / our fork; simulator and MCAP
    replay / the car), chosen by Zephyr board or launch argument
    - ADR-0029: one dev container with every toolchain, used by CI too, on
    Linux, macOS and Windows; boards flashed from the host with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
2026-10-08 build(devcontainer): dev container with Zephyr 4.4.2 and SDK 1.0.1
    Phase 1 of the software setup plan (ADR-0029):
    - .devcontainer/: Ubuntu 24.04 image with the Zephyr SDK (Arm toolchain
    only), west, Zephyr's Python requirements, Node 22 and pnpm. Zephyr
    and its STM32/CMSIS modules are baked in at /opt/zephyr-ws from the
    pin in firmware/sync-mcu/west.yml; west finds them through ZEPHYR_BASE.
    linux/amd64 only (native_sim needs 32-bit host libraries).
    - smoke-test.sh builds and runs Zephyr's hello_world on native_sim and
    builds it for nucleo_h723zg.
    - CI builds the image on changes, runs the smoke test in it, and
    publishes it to GHCR from main.
    - .dockerignore patterns now match at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
2026-10-08 docs: dev container setup in the handbook; phase 0 done, SQ-1 answered
    - Dev setup gets a firmware section: Docker per OS (Rosetta on Apple
    Silicon, WSL 2 on Windows), opening the repo in the container, the
    smoke test, probe-rs on the host for flashing.
    - Setup plan: phase 0 done; phase 1 items as built; SQ-1 answered
    (Zephyr v4.4.2 with SDK 1.0.1, and why not the 3.7 LTS); the VESC
    toolchain moves to phase 4 with SQ-3.
2026-10-08 ci(devcontainer): drop the platform input
    With platform set, devcontainers/ci exports an OCI tarball through
    buildx, which the default Docker driver can't do and which couldn't run
    the smoke test anyway. The runner and devcontainer.json are amd64.
2026-10-08 feat(sync-mcu): scaffold the firmware for three targets, with tests and CI
    Phase 2 of the software setup plan (ADR-0028). Scaffolding only: the
    structure, build, tests and CI, with every module a stub.
    - app/: one module per job (time base, sensors, CAN buses, safety, sync
    link), each stating what it will do and which ADRs it implements. The
    safety stubs are fail-safe: a zero command, an envelope that allows no
    motion, a watchdog that's always expired.
    - boards/arc/arc_sync/: our board definition, a skeleton on the internal
    64 MHz oscillator and LDO supply until the EE picks the crystal,
    package, supply and pins
    - tests/safety/: a placeholder ztest suite on native_sim that checks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
    [can_buses.h, main.c, safety.c, safety.h]
2026-10-08 docs(systems): ICD-sync-link outline; recommend MAVLink 2 for it (ADR-0031)
    Phase 3 of the software setup plan:
    - ICD-sync-link: everything between the sync MCU and the Orin except
    time sync. UDP; every message carries version, type, sequence number
    and sample time; message families each way, with their rates and
    timing from ADR-0021, ADR-0024, SYS-04, SYS-19, SYS-22 and SYS-29.
    Addresses, encoding, the heartbeat path and owners are open.
    - ADR-0031 (Proposed, a recommendation): MAVLink 2 with our own message
    set: fixed-layout and cheap on the MCU like a custom format, but with
    an existing generator for C/C++/Python, built-in sequence numbers and
    CRC, and a Wireshark dissector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
2026-10-08 docs(systems): recommend Gazebo Harmonic (ADR-0032) and VESC 7.00 (SQ-3)
    - ADR-0032 (Proposed, a recommendation): Gazebo Harmonic as the
    simulator backend, the recommended pairing for ROS 2 Jazzy, in the dev
    container, with a community event-camera plugin for the two GenX320s.
    Webots is the alternative if container performance is too poor on
    macOS or Windows.
    - SQ-3 recommendation: fork upstream release_7_00 (firmware 7.00, the
    current stable release).
2026-10-08 docs(systems): ADR-0032 recommends pluggable simulator backends
    Rendering six frame cameras and two event cameras is expensive, and
    containers on macOS get no GPU, so no single simulator suits everyone.
    The recommendation (still Proposed) is now one backend package per
    simulator behind the car interface, chosen at launch (sim:=gazebo |
    webots | gym): Gazebo Harmonic for the full sensor suite and event
    cameras, Webots for camera work on macOS and Windows with the host GPU,
    the F1TENTH gym for fast experiments and CI. One URDF describes the car
    for all of them; sensor profiles keep scenes light. Phase 5 scaffolds
    the packages, it doesn't integrate the simulators.
2026-10-08 docs(systems): vendor the VESC firmware by script (ADR-0033, supersedes 0030)
    ADR-0030's git subtree arrives through merge commits, which this repo's
    rebase-only merging can't take (a rebased subtree import replays
    upstream at the repo root). ADR-0033 keeps the goal and the GPL-3.0
    boundary and changes the mechanism:
    - tools/vesc-upstream.sh import <ref> copies upstream vedderb/bldc into
    firmware/vesc/bldc/ and records the commit in firmware/vesc/UPSTREAM
    - update <ref> applies upstream's diff since that commit with a
    three-way merge, keeping our changes and marking real conflicts
    - both skip lispBM's test reports, REPL, tests, docs and examples, which
    the firmware build doesn't use (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
2026-10-08 docs: state the GPL-3.0 exception for firmware/vesc (ADR-0033)
    ADR-0033 requires the root README and LICENSE to say that firmware/vesc/
    follows upstream's GPL-3.0 while the rest of the repo is MIT. The note
    goes at the end of LICENSE so GitHub still detects the MIT licence.
2026-10-08 docs(systems): accept ADR-0031 (MAVLink 2) and ADR-0032 (all three sims)
    Webots stays because the team has no shared Linux machine with a GPU.
    Phase 4 (VESC fork) is on hold while the electrical team considers an
    off-the-shelf motor controller.
2026-10-08 docs(systems): off-the-shelf A50S motor controllers; top speed 9 m/s (ADR-0034)
    The electrical team won't design a motor controller. ADR-0034 picks the
    Team Triforce A50S V2.3c: the smallest VESC-firmware board, whose
    hardware config is already upstream. Robotics servo controllers
    (moteus, ODrive) can't reach the motor's speed; car ESCs have no CAN.
    - Four A50S on the lower deck, running our VESC firmware build
    - Commands stay on the classic CAN bus; telemetry moves to one UART per
    controller (full status at 1 kHz, stamped at sampling), so the two
    drive CAN-FD buses and their hardware go away
    - E-stop: firmware brake ramp, then the power board cuts the motor bus
    - A max-eRPM limit keeps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
    [bus-load.csv, cost.csv, latency.csv, mass.csv, power.csv]
2026-10-08 feat(sync-mcu): stub the motor-controller telemetry links
    ADR-0034 moves motor-controller telemetry from CAN-FD to one UART per
    controller. Adds a controller_links stub next to can_buses, and updates
    the firmware READMEs and the docs index card to match.
2026-10-08 docs(systems): A50S pinout, SWD on the connector, corner-swap step
    From Triforce's product page and pinout image: the 20-pin latching
    Pico-Clasp carries CAN, UART, PPM (ESTOP), Halls, motor temp, SWD and
    an aux logic-power input. SWD on the connector mitigates RSK-20.
    ICD-corner-connector gets the layout; the corner swap procedure gets
    the config-load step that ADR-0034 adds.
2026-10-08 docs(systems): close SQ-3, heartbeat path, heatsink and motor-temp items
    - SQ-3: VESC firmware from release_7_00
    - Heartbeat reaches the sync MCU only via the Orin, so a hung Orin stops
    the car (ICD-sync-link open issue 3)
    - A50S bought with the heatsink option; BOM, cost and mass updated
    - Castle doesn't document a thermistor on the 1010's sensor cable, so
    E-28 is bought as a fallback and the port is checked on arrival
    - SQ-5 recommends a NUCLEO-H723ZG in the single order
    [cost.csv, mass.csv]
2026-10-08 docs(systems): sync MCU pin-mux fits; Pico-Clasp latch confirmed
    Checked the sync board's I/O against Zephyr's STM32H723ZG (LQFP144) pin
    data: Ethernet, 3 FDCAN, 5 UARTs, 4 SPI, 2 I2C, 6 timer outputs and 22
    GPIO all fit with 37 pins spare. An example assignment shows
    feasibility; the pin choice stays with the EE. Molex lists the A50S's
    Pico-Clasp housing with an inner positive lock.
2026-10-08 docs(systems): provisional A50S circuit numbers; two stale entries
    - ICD-corner-connector: Molex 501189 circuit numbering applied to
    Triforce's pinout, provisional until a 5 V / 3.3 V check on the first
    unit
    - ICD-corner-mechanical: the corner's connectors are now the motor
    phases and Hall cable (ADR-0034), not XT60 + 10-pin
    - mass.csv: Hokuyo UST-10LX 130 g from its datasheet
    [mass.csv]
2026-10-08 docs(systems): motor-bus switch fails open; broken-wire trade-off accepted
    The power board's motor-bus switch opens when unpowered, so a dead
    e-stop circuit also cuts torque. A broken ESTOP wire to one controller
    brakes the car through SYS-25 without the hardware cut; accepted.
2026-10-08 docs(systems): draft the sync-link message set (ICD-sync-link, ADR-0031)
    systems/icd/sync-link.xml: one MAVLink 2 message per family in the ICD
    (IMU, angle, ride-height, motor, steering, camera-trigger, power,
    safety-state and fault samples; drive commands, operator heartbeat and
    envelope settings back). Every message starts with time_ns in sync-MCU
    time. Gap detection uses MAVLink's per-link sequence; the protocol
    version travels in ARC_LINK_STATUS. Draft for both owners to review.
2026-10-08 feat(sync-mcu): generate the sync-link code into firmware and ROS
    tools/gen-sync-link.sh runs mavgen on systems/icd/sync-link.xml into
    the sync MCU firmware and the ROS car backend; --check fails on stale
    output and runs as nx check sync-mcu in CI. mavgen's build date is
    pinned so the output depends only on the schema. A round-trip test on
    each side proves the generated code builds and parses its own frames.
    [arc_sync_link.h, main.c, testsuite.h, version.h]
2026-10-08 docs(systems): draft ICD-controller-telemetry (UART link, ADR-0034)
    The A50S controllers send ARC_MOTOR_STATUS from the sync-link message
    set over their UARTs, time_ns in their own clock; the sync MCU maps it
    and forwards the same message. One schema and one generated library
    for both links. A 60-byte frame at 1 kHz is ~20% of 3 Mbit/s; the
    bus-load and latency budgets now use that. Clock alignment stays open.
    [bus-load.csv, latency.csv]
2026-10-08 docs(systems): can-command.dbc from the stock VESC CAN protocol
    Set current, brake current and RPM commands, and status 1, 4 and 5,
    for controller IDs 1-4 (FL-RR, draft), taken from release_7_00's
    comm/comm_can.c: extended IDs (packet << 8 | id), big-endian.
2026-10-08 feat(sync-mcu): generate the command-bus CAN code with cantools
    tools/gen-sync-link.sh becomes tools/gen-interfaces.sh and also runs
    cantools on systems/icd/can-command.dbc (date stamp normalised). A test
    checks the generated code against VESC's own packing both ways. The dev
    container pins cantools 44.2.1.
2026-10-08 fix(vesc): force-add on import so upstream's .gitignore can't drop files
    Upstream bldc ignores 'tools' and '.vscode', which made git add skip
    lispBM/lispBM/tools/ and .vscode/ that upstream tracks. Import now uses
    git add -f on the fresh snapshot. Updates don't need it: git apply
    --3way stages what it changes.
2026-10-08 chore(vesc): import upstream bldc release_7_00 (20cbb36268)
    Vendored by tools/vesc-upstream.sh (ADR-0033) at the ref chosen in
    SQ-3. Upstream source, unmodified, GPL-3.0; lispBM's test reports,
    REPL, docs and examples are left out. Recorded in firmware/vesc/UPSTREAM.
    [overvoltage_test_v1.ods, overvoltage_test_v2.ods, pi_stm32.cfg, stm32-bv_openocd.cfg]
2026-10-08 build(devcontainer): add Arm GCC 7 2018-q2 for the VESC firmware
    Upstream release_7_00 builds with it. Downloaded from Arm with the
    checksum pinned; on PATH after the Zephyr SDK, which uses its own
    prefixed compilers. The smoke test prints its version.
2026-10-08 feat(vesc): build the A50S firmware; stub our additions with host tests
    - nx build vesc runs upstream's make fw_a50s_v23c_12s (~8 s)
    - firmware/vesc/arc/ holds the e-stop routine, UART telemetry and speed
    limit as fail-safe stubs (engaged, 0 eRPM), with a CTest host test;
    each joins the bldc build as it's implemented
    - tag env:dev-container, so CI builds and tests it in the container
    [estop.c, estop.h, speed_limit.h, telemetry.h]
2026-10-08 feat(ros): one stub backend per simulator; sim:= and sensors:= (ADR-0032)
    arc_backend_sim becomes arc_backend_sim_gazebo, _webots and _gym.
    platform.launch.py picks the backend from target:= and sim:= at launch,
    and passes sensors:=lidar|stereo|all to every backend. A launch test
    per backend checks that the chosen one, by name, comes up.
2026-10-08 feat(sync-mcu): firmware in the loop over the sync link (phase 6)
    - sync MCU: on native_sim, sync_link exchanges ARC_LINK_STATUS with the
    Orin once a second over the host's sockets (Zephyr offloaded sockets);
    ports and peer address in Kconfig. Other boards keep the stub until
    the Ethernet stack is set up
    - ROS car backend: the matching UDP endpoint (ports as parameters)
    - tools/firmware-in-loop: nx test firmware-in-loop runs both and passes
    when each logs "sync link up"; tagged for the dev-container CI job
    - ICD-sync-link: ports 52000 (sync MCU) and 52001 (Orin) proposed, TBC
2026-10-08 docs(systems): answer SQ-5: two NUCLEO-H723ZG boards in the order
    Same MCU and package as the sync board, with ST-Link and Ethernet: sync
    MCU firmware runs on real hardware before the sync board exists, gives
    a known-good reference for its bring-up, and a fallback. Two boards
    plus two 3.3 V CAN transceiver breakouts (G-04, G-05), ~$70.
    [cost.csv]
2026-10-08 docs: bring AGENTS.md up to date with firmware, ROS and codegen
    The layout table, project list and commands now cover the sync MCU and
    VESC firmware, ROS, experiments and the dev container. New rules:
    generated code comes only from systems/icd/, firmware/vesc/bldc is
    GPL-3.0 upstream code updated by script, safety functions stay
    fail-safe with their own tests. Gotchas: rootless Docker file
    ownership, and upstream VESC's .gitignore.
2026-10-08 fix: upgrade Next.js and React to patch CVE-2025-55182 (React2Shell)
    Next.js 15.5.4 and React 19.1.1 are vulnerable to unauthenticated
    remote code execution through React Server Components (CVE-2025-55182,
    also tracked as CVE-2025-66478; CVSS 10.0). Upgrade both apps to the
    newest releases on the same lines: next 15.5.27, react and react-dom
    19.1.9, eslint-config-next 15.5.27.
    [pnpm-lock.yaml]
2026-10-09 docs(systems): mark the command bus's 1 Mbit/s as TBC everywhere
    ADR-0009 gives the bit rate as 1 Mbit/s (TBC), but architecture.md, the
    BOM (E-50) and bus-load.csv stated it as settled.
    [bus-load.csv]
2026-10-09 docs: bring READMEs, CONTRIBUTING and the handbook up to date
    - libs, hardware, platform and tools READMEs described the old state
    (systems-model "planned", the VESC 6.4 fork board, a platform image
    that doesn't exist yet)
    - apps/docs/README.md was the Create Fumadocs template; now it says how
    to run the site and where its pages come from
    - the root README, CONTRIBUTING, the PR template and the handbook now
    cover the dev container, firmware and ROS commands, and the `test`
    target CI runs
    - point newcomers at the issue index (#110) from the README,
    CONTRIBUTING, AGENTS.md, the handbook and the docs landing page
2026-10-09 docs(systems): record ADR-0034's supersessions and amendments both ways
    ADR-0034 replaced ADR-0004's corner connectors and changed ADR-0019's
    steering bus and ADR-0033's list of our firmware changes, but none of
    the three said so. ADR-0019 amends ADR-0012, which only ADR-0012
    recorded. Status lines, Supersedes/Amends lines and the index only;
    no decision text changes.
2026-10-09 docs(systems): align records with ADR-0034 and the decisions since
    - architecture.md: the motor path, the sync MCU's buses, what triggers
    the hardware cut, and controller cooling described the old design
    - requirements: rationale for SYS-06 and SYS-25 cited the old telemetry
    path; drop the regulator question already answered (>= 30 V with TVS)
    - BOM: steering bus placement (E-31) matches E-30; motor mounts are no
    longer the controllers' heatsink
    - budgets: name what the command-bus status row counts (STATUS_4/5
    rates are TBD); connectors and the 120 A note in power-scenarios
    - verification: R3 is retired; tick the pin-mux check
    - handoff and ICD index: ICDs needing owners; sync-link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
    [bus-load.csv, cost.csv]
2026-10-09 docs(systems): bring the software plan and mechanical docs up to date
    - setup-plan: phase 2 landed but was unticked; the GHCR image is public;
    the simulator backends were listed under their old name; record the
    ground station as not yet scaffolded (#71) and point at the issues
    - software architecture: list ADR-0031, 0032 and 0034
    - mechanical: the controllers sit on the deck, not in the motor mounts
    or the corner assembly
2026-10-09 docs(systems): redraw the topology diagram for ADR-0034
    It still showed the 2026-10-02 design: VESC 6.4 fork boards, two CAN-FD
    telemetry buses, ESTOP_EN, XT60s at the corners, suspension pots and
    the stop sequence at 12 m/s. Now: A50S controllers on the deck with a
    UART each, the power board's motor-bus switch, the sync board I/O from
    the BOM tally (pin-mux checked), and the stop sequence at 9 m/s with T
    drawn as TBC.
2026-10-09 docs(ros): correct the package table and document defaults and tests
    The Orin has no CAN bus and no watchdog: drop the VESC/CAN bridge (and superseded ADR-0011) from arc_drivers, and say arc_safety only forwards the heartbeat. Say what the car backend actually does, name it as the sync bridge, document the launch defaults, the car backend's parameters, the gtest and the generated code.
2026-10-09 docs(sync-mcu): say what the modules do and document tests and config
    The README called every module a stub; sync_link, time_base and the watchdog init work. Add the Kconfig options, the board overlay, the twister suites and the ROS copy of the generated code; add the telemetry UARTs and ADR-0034 to the firmware overview; point controller_links.h at the ICD that now exists.
2026-10-09 docs(vesc): describe the telemetry encoding and the state of bldc/
    bldc/ has no ARC edits yet (our code is in arc/); say so. Name the telemetry encoding, UART and pins, that nothing is generated into this firmware yet, and soften the speed-limit and RSK-12 claims to what's verified. Document vesc-upstream.sh's behaviour and the harmless ARM-SDK warning.
2026-10-09 docs(systems): correct the software docs, sync-link ICDs and link budgets
    Nothing is generated into the VESC firmware yet; native_sim has no loopback CAN or simulated sensors yet; the platform image isn't scaffolded. MAVLink 2's header is 10 bytes (58-byte frames, 19% of the UART), and STATUS_1 needs worst-case stuffing like the command frames (160 us, 27.2% total). Steering replies are stamped at the query, ARC_POWER_SAMPLE has no rail currents, and the ports don't mirror the message IDs. Record the A50S UART's 2.625 Mbit/s limit at 16x oversampling as an open issue, list the missing steering-bus and operator-link ICDs, and add the unticked work they imply.
    [bus-load.csv, latency.csv]
2026-10-09 docs: correct the root docs, handbook and tools notes
    Replace the phone number in the Code of Conduct with the contact addresses used everywhere else. ADR-0029 makes the dev container the supported path, not the only one; a .devcontainer-only change is smoke-tested but affects no Nx project; ROS tests include the sync-link round trip; the .dbc generates only into the sync MCU. Add missing commit scopes, the firmware rules to CONTRIBUTING, the docs-site mount URLs and carSidebar, E-nn to the ID table, tool usage, and fix the LFS (no loose gerbers), extensions and website claims.
2026-10-09 docs(systems): mark open values TBC and fix stale records
    Undecided values written with '~' (watchdog timeout, deceleration, SYS-25 silence, the eRPM limit) are now TBC with their source. SYS-05 cites ADR-0034's amendment; LIM-07 records the A50S's coarse current signal. The retired RSK-03 test and LTspice item no longer read as not started or done, the pin-mux tick says what was checked, the gear table shows top speed under the eRPM cap, and idle current matches its power.
2026-10-09 docs: update the Fusion page, CAD checklist and failure template
    Name the Fusion project and the LFS step; add ADR-0034's lead routing and controller heatsink checks to the pre-order CAD checklist; the failure report's drive area names the A50S, not a VESC board.
2026-10-09 docs(systems): set the controller telemetry UART to 2 Mbit/s
    [bus-load.csv, latency.csv]
2026-10-09 feat(systems): report each corner's state and brake on command loss
    ADR-0035. The controllers brake on the e-stop ramp after 150 ms (TBC)
    without a command, replacing upstream's 1000 ms timeout that coasts.
    ARC_MOTOR_STATUS gains a state bitmask (e-stop, command timeout), and
    SYS-25 now triggers on a silent, self-braking or faulted corner, or a
    failed command bus, so a broken ESTOP wire or a corner that stops
    receiving commands stops all four. Schema version 2; code regenerated.
    [bus-load.csv, latency.csv]
2026-10-09 docs(systems): set T after the stop and correct the SYS-04 distance
    T is 2.4 s (TBC): the stop from 9 m/s takes ~1.9 s with its ramp, and
    the ~1.8 s used so far left T before the stop. SYS-04's total is
    ~10.1 m with the ramp included, not ~9.5 m.
    [power.csv]
2026-10-09 feat(systems): stop sending STATUS_4 and STATUS_5 on the command bus
    Everything in them is in the UART telemetry; the controllers send
    STATUS_1 only. Code regenerated.
    [bus-load.csv]
2026-10-09 docs(systems): confirm the command bus at 1 Mbit/s; fix ADR-0009's DBC link
    [bus-load.csv]
2026-10-09 docs(systems): supersede ADR-0013 with a steering-bus physical layer (ADR-0036)
2026-10-09 docs(systems): note ADR-0019's stale bus count and cut time in its status
2026-10-09 docs(systems): record that our VESC code lives in arc/ (ADR-0037)
2026-10-09 docs(systems): restate RSK-03 for the steering CAN-FD bus
2026-10-09 docs(systems): record the open EE, tyre and size-rule questions
    The clamp position and switch inrush, the UART grounding and the lost-
    corner faults on every e-stop go to the EE; the tyre diameter that sets
    SYS-01's margin to mechanical (MQ-6); SYS-02's bounds against the rule.
2026-10-09 docs(systems): stop the car when steering fails (ADR-0038)
    A dead steering bus, a moteus-c1 fault or an untrusted steering angle
    triggers the SYS-25 stop, and drive is refused until the steering is
    healthy.
2026-10-09 docs(systems): trace the 500 Hz drive command rate to SYS-06
    [bus-load.csv]
2026-10-09 docs(systems): also stop on a corner missing from the command bus
    ADR-0035: no STATUS_1 from a corner for ~60 ms (TBC) triggers SYS-25,
    catching a corner that has lost the bus before its own timeout fires.
    [bus-load.csv]
2026-10-09 docs(systems): propose the steering-angle threshold (~3°, 20 ms, TBC)
    How the check compares the knuckle encoders with the moteus-c1, and a
    note that the value needs a second look once the steering is built.
2026-10-09 docs(systems): latch fault stops; reset by an e-stop cycle (ADR-0039)
    A SYS-25 stop latches. Driving resumes only after the e-stop button on
    the car is cycled past T, the power-on checks pass and the operator
    re-arms; some faults need a full restart and an inspection.
2026-10-09 docs(docs): add a Software section built from the code's READMEs
    An overview page maps what runs where, how data, commands and safety
    flow, how to run each target, and the rules for software. The READMEs
    in ros/, firmware/, experiments/, platform/, tools/ and libs/ render
    under /docs/software, and the docs build's inputs include them so nx
    affected rebuilds the site when they change. The car section's own
    software folder is renamed Software design.
2026-10-09 docs(docs): generate the message and project reference pages
    Messages renders every sync-link, telemetry and command-bus message
    from sync-link.xml and can-command.dbc, with payload and wire sizes;
    Projects and commands renders every project.json. Both are built from
    the files the code uses, so they can't drift. CI describes the
    workflows.
2026-10-09 docs(systems): fill component envelopes from vendor data
    Sizes and masses for the UST-10LX, A50S, carrier, camera boards and
    the battery bay, with sources. Adds the two Camarray HATs the Arducam
    kits need, which weren't in the table.
2026-10-09 docs(systems): UST-10LX supply range and startup current
    10-30 V, 150 mA running and 450 mA at startup, from Hokuyo's page;
    the sensor rail must supply the startup current.
2026-10-09 docs(systems): design our own corners, buy only generic parts (ADR-0040)
    Bought cars' corners don't fit the per-wheel gearboxes, the encoders
    at every joint or our steering, and touring cars race at ~1.35 kg
    against our 4 kg or more. We design the knuckles, uprights, arms and
    mounts; shocks, CVDs and wheels come from Arrma 6S (mostly in stock in
    Ontario), bearings and rod ends from industrial suppliers.
    Supersedes M1 and ADR-0027 (never accepted). Adds RSK-21 (gearing and
    power assume 62 mm wheels and 3.5 kg) and RSK-22 (machined corner
    parts right first time).
2026-10-09 docs(systems): gearing and power for 100 mm wheels at 4-5 kg (RSK-21)
    The speed table in architecture.md is redone for the 100 mm tyre:
    16/64 (18:1) reaches ~10.9 m/s at the controllers' eRPM cap. The
    mass-dependent figures (current per corner, peak current, e-stop
    energy) live in power-scenarios.md only, on a stated 4-5 kg guess;
    the BOMs, the ICD and the EE hand-off point there instead of copying
    the numbers.
    [mass.csv, power.csv]
2026-10-09 docs(systems): gearbox dimensions the gears fix
    Shaft spacing and the largest gears from the tooth counts and modules;
    the stage-2 module and the overall size stay open for the CAD. Notes
    where to ask about printers (MQ-1).
2026-10-09 docs(systems): drop stale rationale left by the corner and gearing changes
    SYS-01 no longer ties the speed limit to 13.5:1; SYS-02, RSK-16 and the
    layout brief no longer assume a touring-car wheelbase; LIM-07 points to
    the power scenarios instead of copying ~12 A; SYS-04 gives one rolling
    distance, not two; architecture.md's mechanical section reflects
    ADR-0040 and the block layout.
2026-10-18 docs(systems): mark each power and mass budget row by build
    Give power.csv and mass.csv the build column cost.csv has, and add
    v1.0's rows: the Orin Nano Super developer kit, the 1 TB SSD, the
    UST-20LX and the B0223. Also name the motherboard (ADR-0042) in the
    mass budget instead of stacked boards.
2026-10-18 docs(systems): describe running v1.0 on the Orin Nano dev kit
    builds.md gets the dev kit's power modes (Super needs the Super flash
    configuration on JetPack 7.2), its 9-20 V barrel input, which camera
    goes on which connector, the SSD and Wi-Fi slots, and what's still
    open for v1.0. The ICDs, BOM, handoff, layout brief, architecture,
    RSK-08 and the software architecture name the dev kit where they
    assumed the NX. Also fixes the layout brief's duplicate step 7 and the
    setup plan's "single order".
2026-10-18 docs(systems): show both builds and the motherboard on the topology
    The drawing is still v1.1, but v1.0's substitutes are now written in
    and its missing cameras faded. The stacking header between separate
    power and sync boards goes: they're one motherboard (ADR-0042).
2026-10-18 docs(systems): ask who the sync MCU accepts messages from
    The service port shares the car's switch with the sync link, so a
    laptop plugged in there can reach UDP 52000. Record it as an open
    issue in ICD-sync-link; no option is chosen.
2026-10-25 docs: give electrical, mechanical and software their own sections
    systems/ all mounted under /docs/car, so the electrical handoff, the
    BOMs, the mechanical briefs and the software design sat among the
    car's requirements and decisions. The pages one discipline reads now
    go to that discipline's section (systemsPages in lib/source.ts), with
    redirects from their old URLs, Markdown variants included.
2026-10-25 docs(systems): fix a stale anchor and wrap over-wide text blocks
    The parts selection linked to a heading that had been renamed, and the
    CAD workflow's folder tree overflowed the docs column.
2026-10-26 fix(hardware): keep synced Altium files byte-exact on checkout
    Altium writes .PrjPcb files with CRLF and altium-sync.json records those
    bytes, but the files were committed as LF. On any checkout without
    core.autocrlf=true the hashes no longer matched, and the next sync refused
    the unchanged project as a local edit. Mark each board's altium/ folder
    -text, store the projects as CRLF, and test that the committed manifests
    match the checked-out files.
2026-10-26 chore: list altium-sync and the board scaffolds in AGENTS.md
2026-10-26 docs(hardware): drop a local Altium cache path from the board READMEs
2026-10-26 docs(systems): design the software platform
    Decisions:
    - ADR-0047: one platform for every target. The targets split at the
    devices, not at the car interface, so the same stack, firmware
    included, runs in simulation, on development boards and on the car.
    Amends ADR-0028 and ADR-0032.
    - ADR-0048: the platform provides measurements; experiments own
    estimation, localization, planning and control, command speed and
    steering, may run in real time, and aren't limited in number. A
    baseline estimator is an example experiment, off the critical path.
    Amends ADR-0016; the requirements' "Platform vs experiment" and
    "Layered control" bullets, the experiments README and template and
    the R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
2026-10-26 docs: add the software platform pages to the site
    The software handoff, simulation and platform plan join the software
    section, and its landing page points to where to start.
2026-10-26 docs(systems): record the platform decisions (ADR-0050, ADR-0051)
    - ADR-0050: one platform build for the Orin and laptops on a Jetson
    base and an Ubuntu base, real-time settings in configuration; the
    simulator image for amd64 and arm64; experiments run in Docker.
    Amends ADR-0016.
    - ADR-0051: one car configuration file per car in the repo, its sync
    MCU values compiled into that car's firmware build.
    - The operator re-arms after a reset (ICD-sync-link); the message is
    still to be added to sync-link.xml.
    - Sender filtering on the sync MCU is deferred until before the car
    is assembled.
    - No per-wheel commands for now (ADR-0048's status).
    - SYS-06 reworded: the car supports an estimat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
2026-10-26 docs(systems): record the envelope defaults and heartbeat stop (ADR-0052)
    A new experiment's envelope defaults to 3 m/s, 5 m/s² (TBC) and the
    full steering range; reverse is allowed under the same speed limit.
    After a heartbeat loss the car stays stopped until heartbeats are back
    and the operator re-arms, with no e-stop cycle. Amends ADR-0039; SYS-04
    and ICD-sync-link updated to match.
    Traces to: SYS-04, SYS-22; #75
2026-10-26 docs(systems): record the fault reset's details (ADR-0053)
    The power-on checks after an e-stop cycle may take 3 s (TBC); if they
    don't pass, the car stays stopped and needs another cycle. A wheel is
    stopped at |eRPM| <= 100 (TBC). The steering check is skipped until a
    steering driver exists. Amends ADR-0039.
    Traces to: SYS-25; #148
2026-10-26 docs(systems): set the car's network addresses (ICD-network, #72)
    The ranges and addresses in ICD-network are no longer TBC: the car
    network 192.168.70.0/24 (Orin .1, sync MCU .2, LiDAR .10, service-port
    laptop .100), the team network 192.168.71.0/24 and the hotspot
    192.168.72.0/24. ICD-sync-link points at them. The operator link's port
    stays open (#144).
    Traces to: SYS-24, SYS-27; ADR-0015; #72
2026-10-26 feat(systems): review the sync-link message set (version 3, #73)
    Reviewed by the owner of both sides:
    - ARC_SAFETY_STATE carries the fault latch's state and cause (ADR-0039,
    ADR-0053), so the ground station can say what to do next. The
    watchdog's unused ROLLING becomes NOT_ARMED (same value).
    - ARC_ANGLE_SAMPLE gets the AS5047P's error flags, which ADR-0038's
    "angle can't be trusted" needs; ARC_STEERING_STATUS gets the
    moteus-c1's mode.
    - ARC_REARM (52053), decided 2026-10-25.
    - IMU descriptions follow ADR-0045 (both ISM330DHCX).
    - IDs: VESC controller IDs 1-4 = FL, FR, RL, RR (corner = ID - 1);
    MAVLink system 1, the sync MCU 1, the Orin bridge 2, the motor
    controllers 11-14.
    - R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
2026-10-26 fix(ros): log the car backend's ready line once its timers exist
    The launch test stops the node as soon as it sees "not implemented yet".
    The car backend logged it before creating its timers, so a stop in that
    window made create_wall_timer throw on the shut-down context and the
    process abort (exit -6), failing test_exit_codes. Seen on CI for #193.
    The line is now logged last, also when the UDP bind fails.
2026-10-26 docs(systems): follow ARC_REARM and the corner mapping through the docs
    The handoff, architecture and platform plan still said the re-arm
    message wasn't in sync-link.xml; the UART readiness review still listed
    the corner mapping as TBD. ICD-controller-telemetry goes to revision B
    with ICD-sync-link. Part of #141 (the operator link is #144).
2026-10-26 feat(systems): split the latch causes and settle the re-arm state (#73)
    - ARC_LATCH_CAUSE: CORNER covers the corners only; COMMAND_BUS,
    STEERING and STEERING_DISAGREEMENT (restart, ADR-0039 item 5) added,
    so the cause names what SYS-25 saw.
    - ARC_WATCHDOG_STATE: NO_HEARTBEAT (was BRAKING) while no heartbeats
    arrive, NOT_ARMED once they do until the re-arm. This answers
    ADR-0052's question, recorded as ICD-sync-link open issue 7.
    - ARC_ANGLE_STATUS_NOT_READY: the AS5047P's offset compensation isn't
    done yet (LF clear).
    Enums only, so the messages' CRCs don't change; still version 3, not
    released yet. Code regenerated with tools/gen-interfaces.sh.
2026-10-26 ci: add the clang-format and ruff configs, without reformatting
    - firmware/: Zephyr's .clang-format, copied unchanged. Today's
    firmware needs 4 lines changed.
    - firmware/vesc/bldc/ and ros/: clang-format disabled. Upstream VESC is
    never reformatted (ADR-0033); ROS C++ already passes ament_uncrustify,
    which clang-format would fight.
    - .clang-format-ignore: the generated code.
    - ruff.toml: ruff's defaults at 99 columns, for tools/ and experiments/.
    ros/ruff.toml: the ROS 2 style (single quotes, Google import order),
    lint only, since ruff's formatter rewraps every launch file.
    - CONTRIBUTING: a code style table.
    Nothing is reformatted and CI doesn't check the configs yet: applying
    th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
2026-10-27 docs(systems): draft ICD-ros2-msgs, the car interface (rev A, #84)
    The ROS 2 topics and services between the car backend and the Orin's
    drivers and everything above them: the measurements, the car's state,
    the commands to the car, and the platform topics experiments use.
    - Conventions: sample-time stamps on the sync MCU's time base (SYS-07,
    ADR-0021, ADR-0049), SI units and REP-103/105 frames, one topic per
    sensor, standard types where they fit.
    - Constants mirror the sync link's enums, checked at compile time.
    - Four QoS profiles; topic names, types and QoS are TBC until sign-off.
    - How the simulator branch's /sim/* topics map onto it, without
    changing that branch.
    Open issues: high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
2026-10-27 feat(ros): define the car interface's messages in arc_msgs (#84)
    Twelve messages and one service from ICD-ros2-msgs, replacing the
    placeholder: AngleSample, MotorStatus, SteeringStatus, CameraTrigger,
    Envelope, SafetyState, Fault, LinkStatus, DriveCommand, Heartbeat,
    Rearm, ControlMode and SetControlMode. The rest of the interface uses
    sensor_msgs, nav_msgs and diagnostic_msgs.
    test_msg_constants in arc_backend_car static_asserts every constant
    against the generated sync-link enums, including each enum's size, so
    a value that drifts or an entry added on one side fails the build.
    Nothing publishes the messages yet (#85).
2026-10-27 docs(systems): settle ICD-ros2-msgs review items (#84)
    base_link at the rear axle, QoS history sized to 100 ms, the missing
    topics (ground velocity, clock, transforms) and one publisher per
    command, enforced by the car backend.
2026-10-27 chore(deps): fix the npm security alerts
    Refresh the lockfile within the ranges package.json already allows
    (pnpm update -r --no-save), keeping fumadocs-docgen at 3.0.1: 3.2.0
    needs fumadocs-core 16. That moves 125 packages, among them React
    19.1 -> 19.3, Tailwind 4.1 -> 4.3, ESLint 9.35 -> 9.39 and Nx 22.7.12.
    Packages whose parents pin a vulnerable version get scoped overrides
    in pnpm-workspace.yaml: axios, follow-redirects, smol-toml and
    brace-expansion under Nx, postcss under Next, zod under
    fumadocs-docgen.
    pnpm audit: 70 -> 1. The one left is low: katex under mermaid 11,
    which pins ^0.16; the fix is katex 0.18 or mermaid 12.
2026-10-27 feat(config): add the car configuration files and their schema (#143)
    config/cars/: nominal.yaml holds the car as designed (wheelbase and
    track, tyre, gearing per axle, steering), each value with its source or
    marked as a placeholder until the block layout (#103) sets it; twin.yaml
    extends it unchanged. A physical car's file extends nominal and overrides
    only what was measured. schema.json checks the merged values; nx check
    car-config loads every car.
    Out of the files: the CAN IDs (fixed by can-command.dbc), rates and
    timeouts (ICD constants), and anything derived, such as the top speed.
    Not yet: sensor positions and mass properties, which wait for the block
    layout and may belong in the URD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
2026-10-27 feat(ros): load and check the car configuration at launch (#143)
    arc_car_config merges a car's file over the one it extends, validates
    it, hashes it (for the run record, #152) and works out the top speed;
    car_config show prints a car's merged values.
    platform.launch.py takes car:= (default twin), checks the file before
    anything starts and logs its hash, so a missing or invalid car stops the
    launch and fails every backend's launch test. ros now depends on
    car-config, so a car file change runs the ROS tests.
2026-10-27 docs(systems): record the car configuration's values (ADR-0054)
    Amends ADR-0051: the design values are written by hand in
    config/cars/nominal.yaml, each with its source, not generated from
    systems/ (#174); the CAN IDs, rates, timeouts and derived values stay
    out of car files; sensor positions and mass properties wait for the
    block layout and the URDF. As implemented in #202.
2026-10-27 docs(systems): bring the docs up to ADR-0054
    simulation.md's parameters section, the platform plan's #174 row and the
    software handoff no longer describe a generator. ICD-ros2-msgs open
    issue 3 waits on the URDF, and issue 4 now only needs the m/s field.
    ADR-0047 notes that the CAN IDs aren't per car.
2026-10-27 docs(systems): note that ADR-0017's CAN-FD telemetry buses are gone
    Its Context still described two CAN-FD telemetry buses, which ADR-0034
    replaced with a UART per motor controller. The decision is unchanged.
2026-10-29 docs(systems): record how arc_control chooses who drives (#151)
    The mode is the switch: operator mode forwards the teleop, experiment
    mode the experiment. Only a set_mode request hands the experiment
    control, and only while it's publishing; teleop past a deadband takes it
    back, and so does a lost experiment. A silent source in control gets the
    zero command (speed 0, steering held, as hard as the envelope allows).
    Timeouts, deadband and tick are TBC.
2026-10-30 docs(systems): add ADR-0055, every e-stop press latches the stop
    Record the owner's decision: a plain e-stop press latches the sync
    MCU's stop, not only a SYS-25 fault. Driving resumes after the release,
    the power-on checks and the operator's re-arm, with zero commands
    first. Proposed until the latch's implementer (#148) has reviewed it.
    ADR-0012 and ADR-0039 record the proposed amendment on their status
    lines; open questions are listed in the ADR.
2026-10-30 docs(systems): record the owner's answers to ADR-0055's questions
    A press is not a fault: with the input pressed, corners reporting the
    e-stop are expected and the cause is the e-stop; an active fault latch
    keeps precedence. Releasing the button is the cycle, the envelope
    returns to its default on the re-arm, and any corner's e-stop report
    latches as a backstop. Two questions these raise are listed as open.
2026-10-30 docs(systems): propose strict answers to ADR-0055's open questions
    The owner's proposed answers, for Ashwin's review with the rest of the
    ADR, chosen on the strict side:
    1. A corner's e-stop report that the input missed is reported as a
    wiring fault (a restart, and the wiring looked at), not as the
    e-stop. The two may disagree for at most TBC 20 ms before it counts.
    2. A button held at power-on resets the power-on latch only if it was
    held at least T, the same rule as resetting a fault stop.
    Both stay open questions until the ADR is accepted.
2026-10-30 docs(systems): decide ADR-0055's edge cases, and name motor controllers
2026-10-30 feat(ros): add arc_logging, every topic of a run to MCAP (#152)
    Runs rosbag2's own recorder (ros2 bag record --all-topics, MCAP storage)
    in its own process, into one directory per run, so the log is a standard
    rosbag2 log the replay backend (#86) reads with plain rosbag2. The run
    record so far (target, sensors, car, car configuration hash) is written
    as the log's custom data; versions (#160) and the rest come later.
    A launch test runs a platform talker and an experiment that is killed
    mid-run, then reads the MCAP back: both topics, the platform's messages
    after the crash, and the run record.
2026-10-30 feat(ros): log every run from the platform launch (#152)
    platform.launch.py includes arc_logging with the run's target, sim,
    sensors and car, and a new log_dir:= argument. The launch test logs to a
    temporary directory and waits for the recorder on every backend.
2026-10-30 fix(ros): conservative logging values, and harden the recorder's handling (#152)
    The values, all still TBC:
    - min_free_gb 20 -> 270 GB. A v1.0 run logs ~178 GB (~296 MB/s,
    bom/total-electrical-cost.md, over SYS-03's 10 min), so 20 GB filled
    in about 70 s. 270 GB is a full run x 1.5.
    - warn_free_gb, new, 60 GB (~3 min of v1.0 logging): the warning while
    recording. It used min_free_gb, which at 270 GB would warn partway
    through nearly every run with plenty of space left.
    - chunk_s 60 -> 15 s: a crash or power loss loses at most 15 s.
    - start_timeout_s 10 -> 5 s: rosbag2 starts in ~1 s on a desktop. On the
    car the status is a warning until it records anyway.
    The handling:
    - The recor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
2026-10-30 docs(systems): log camera images only on runs that ask (ADR-0056)
    Every run logged every sensor at full rate, ~178 GB per 10-minute run on
    v1.0, nearly all camera images, and a drive without room for them meant
    no log at all. ADR-0056 has each run log a profile: everything but
    camera images by default, images too when a run asks, falling back to
    the default when the drive can't hold them. SYS-09 and SYS-24 are
    reworded to match, and the 10-bit packing the log rate assumes is an
    open item.
2026-10-30 feat(ros): log a profile per run, everything but images by default (#152)
    log_profile:= on the platform launch picks what a run records
    (ADR-0056): minimal, every topic except camera images, left out by
    message type, or full, every topic. minimal is the default on every
    target. A full run without room for it records minimal and warns,
    instead of recording nothing. Free space to start and to warn is the
    profile's unless min_free_gb or warn_free_gb is given, and the run
    record names the profile recorded.
    Checked against ADR-0056's table, the image types in ICD-ros2-msgs,
    rosbag2's flags and bringup's arguments, and as processes: each
    profile's topics, and a full run falling back.
2026-10-30 docs(systems): set T to 2.8 s and the car's mass to 4.2 kg (ADR-0057)
    From the speed cap (~10.9 m/s) the e-stop's stop takes ~2.26 s, which
    left T = 2.4 s ~0.14 s of margin. T is now 2.8 s (TBC), covering a
    brake down to ~4 m/s², with its tolerance TBD within SYS-05's 3 s.
    The nominal mass is 4.2 kg (TBC) until the car is weighed. The brake
    current, the stop time against T and the braking energy use 5 kg, the
    safe side; the nominal car then brakes at ~6 m/s², which the floor's
    grip has to support.
2026-10-30 feat(tools): run the sync MCU firmware in Renode on a NUCLEO-H723ZG
    Renode has no STM32H723 platform. nucleo_h723zg.repl builds one on
    Renode's NUCLEO-H753ZI: FDCAN3, SPI1, the backup-regulator bit Zephyr's
    backup SRAM driver waits on, and the board's 275 MHz timer and 550 MHz
    DWT clocks. nucleo_h723zg.resc loads the nucleo_h723zg build (#178).
2026-10-30 docs(systems): record the Renode investigation of the sync MCU (#178)
    The nucleo_h723zg build boots in Renode 1.17.0, and Zephyr's FD-CAN,
    Ethernet, PTP, GPIO and timer tests pass on the H723 platform; SPI has
    no device behind it. The arc_sync build panics: logging is on with no
    log backend. Ends with a proposal for the owner and its open questions.
2026-10-30 build(vesc): build arc/ into the firmware
    One line in bldc/make/fw.mk includes arc/arc.mk, which adds every
    source in arc/src/ (host-tested) and arc/port/ (firmware-only glue) and
    arc/include/ to upstream's build (ADR-0037). The README says bldc/ now
    carries these hooks.
2026-10-30 feat(vesc): cap the motor's eRPM whatever is commanded (#83)
    arc_speed_limit_erpm() returns the cap, 75k eRPM (TBC, ADR-0034,
    RSK-18), instead of the stub's 0. arc_speed_limit_apply() clamps a
    configured eRPM limit pair into [-cap, cap]: a tighter configuration is
    kept, a looser one, an infinity or a NaN becomes the cap.
    The hook in bldc/motor/mc_interface.c runs it at the top of
    update_override_limits(), on every configuration change and timer tick,
    so it also covers COMM_SET_MCCONF_TEMP, which writes the live
    configuration directly. Upstream then enforces l_min_erpm/l_max_erpm in
    current, duty and speed control.
    Host tests cover upstream's defaults, the hardware limit, tighter and
    asymme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
2026-10-30 docs(vesc): add a place for each motor's detected configuration (#83)
    firmware/vesc/motors/motors.csv keeps each drive motor's detected
    resistance, inductance, Ld - Lq, flux linkage and Hall table, keyed by
    the label on the motor, so a corner swap stays configuration only
    (SYS-13, ADR-0034). Template only: no motor has been detected yet, so
    it has a header and no rows. The README says how to record a motor and
    load its values with VESC Tool.
2026-10-30 docs(systems): add the motor config step to the corner swap (#83)
    ICD-corner-mechanical's swap procedure now lists the controller step:
    read the motor's label, load its row from firmware/vesc/motors/ with
    VESC Tool, or run detection and record it for a motor with no row. The
    mechanical steps, tools and time stay TBD.
2026-10-30 docs(vesc): say the eRPM limit is a soft cut-back, not a brake (#83)
    Upstream's eRPM limit cuts back the motor current near the limit and
    truncates speed-mode setpoints; it can't stop overspeed driven from
    outside, such as rolling downhill or being pushed. speed_limit.h, the
    hook comment in mc_interface.c and the README now say so, and that the
    R2 sweep confirms how the motor behaves at the limit (RSK-18).
2026-10-30 test(vesc): never compile the speed-limit suite's asserts out (#83)
    test_speed_limit.c checks with assert(), so a build with NDEBUG would run
    it with every check removed and pass. It now undefines NDEBUG before
    including assert.h.
2026-10-30 test(vesc): check the eRPM limit over every float and against its sources (#83)
    - test_speed_limit_props.c applies the limit to every kind of configured
    pair (5 million random bit patterns, plus the edges: the limit and its
    neighbours, infinities, NaNs): the result is never NaN or outside the
    limit, a tighter setting is kept, and applying it again changes nothing.
    - speed_limit_values.py checks the limit is erpm_max in
    config/cars/nominal.yaml, still gives ADR-0034's >= 10 loop samples per
    electrical cycle, still reaches SYS-01's top speed with the higher
    gearing, and is still applied in update_override_limits() on every
    timer tick: an upstream update that drops the hook still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
2026-10-30 feat(ros): play MCAP logs in the replay backend
    target:=replay log:=<log> rate:=<r> plays a rosbag2 MCAP log (a file
    or a bag directory) through the car interface with the log's timing,
    scaled by rate. Only the car's topics are played (ICD-ros2-msgs,
    Side A); commands, /control, /estimate and /tf in the log are left to
    the live platform. /clock comes from the player on the log's time and
    stops at the end of the log. Commands sent to the car are received,
    the first per topic logged, and dropped.
    A launch test replays a sample log, written by a script with fixed
    values so it's reproducible, at 0.5x, 1x and 2x. The bringup test now
    waits for each backend's startup line rather than "not impleme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
2026-10-30 test(ros): check the replay backend's topics against ICD-ros2-msgs (#86)
    test_topics_contract.py reads the ICD's tables and backend.cpp, and
    checks that replay plays every topic the car publishes (the sync link's
    and the drivers' measurements, ground velocity and the car's state, 36
    topics), plays none of the others (/clock, the transforms, the commands,
    the platform's /control and /estimate topics), and listens on exactly the
    ICD's command topics with each one's QoS profile.
    A topic added to the ICD, or a change to kCarTopics or the command sink,
    now fails here instead of a replay quietly missing it. Dropping power,
    diagnostics or a sensor family from the regex, replaying the commands,
    dro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
2026-10-30 feat(ros): name the car topics a replayed log doesn't have (#86)
    A node waiting on a topic the log doesn't hold got nothing and no word
    why. The backend now reads the log's topic counts before playing and
    warns once with the car's topics (ICD-ros2-msgs' Side A) that have no
    messages: camera images in a log recorded without them (#152), topics
    left out by log_exclude:=, or a sensor that was down.
    The car's topics are listed by name beside the pattern that plays them;
    the contract test keeps the list and the ICD the same. The sample log
    gains a car topic with no messages, and the launch test checks the
    warning names exactly the car topics the log doesn't have.
2026-10-30 feat(tools): add the split check for ADR-0047
    Fails if code above the split branches on which target it's on: a
    target name in a branch condition outside board files, device models,
    configurations, backends and bringup. The allowed places are path
    globs, so new ROS packages and firmware modules are checked by default.
    Runs as nx check split-check; tested with nx test split-check.
    Refs #176
2026-10-30 ci: build and test ROS on arm64
    The Orin is arm64 (ADR-0050) and the dev container is amd64 only, so a
    new job installs the dev container's ROS 2 Jazzy packages on GitHub's
    arm64 runner and builds and tests the workspace there when ROS is
    affected. The sync MCU (all three boards) and VESC builds already run
    in the dev-container job; the CI page now says so.
    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
2026-10-30 test(tools): check the split check against code written to get past it (#176)
    split-check.adversarial.test.mts, written apart from the worked cases:
    - every target, world and board name (written out from ADR-0047 and
    simulation.md, not read from rules.mts) is caught in a Python, C++ and
    shell comparison, and every identifier word in snake and camel case;
    - the ways of asking that are caught: Zephyr board and architecture
    symbols in C, CMake and Kconfig, the environment, parameters, match,
    lookup tables, ternaries, launch conditions in Python and XML, shell
    case patterns;
    - what's left alone: use_sim_time, comments, car_config, a run record,
    words that merely start with a target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
2026-11-05 test(ros): read the replay's missing-topics warning as a whole line
    The launch test split each chunk of the backend's output into lines, so a warning that arrived in two chunks was read cut short and failed the count. It now joins the output first. Seen once in a full run; five runs pass with the fix.
2026-11-05 feat(ros): stamp the workspace's git version and log it (#160)
    A new package, arc_version, writes the git commit the ROS workspace was
    built from at every build, with "-dirty" when ros/ or config/ had
    uncommitted changes, or "unknown" outside a git checkout. Only those
    paths count: elsewhere, Git LFS files read as changed to a git without
    the LFS filter, as in the dev container.
    Bringup prints it at start and puts it in the run record as
    ros_version. The firmware's versions and the ground station's are the
    rest of #160.
2026-11-05 test(vesc): run arc/'s host tests under sanitizers, and check coverage (#159)
    The host tests now build with AddressSanitizer and
    UndefinedBehaviorSanitizer by default, so a memory error or undefined
    behaviour fails a test even when the value it checks comes out right.
    nx test vesc then rebuilds them with gcov and fails unless every line
    and branch in arc/src/ runs. That's 100% today, on main and with the
    e-stop routine (#80) merged; the minimum is proposed here, pending the
    team's call in #159. The sync MCU's half of #159 is separate.
2026-11-05 docs: set the coverage minimum for the VESC modules (#159)
2026-11-05 feat(vesc): add the e-stop brake routine's logic, with host tests (#80)
    arc_estop_step() is the routine as pure C (ADR-0012, ADR-0034): ESTOP
    low engages it; while engaged or released it ignores motor commands and
    ramps brake current from 0 to the target over the ramp time, then holds
    it. A release waits for a command seen after the release step before
    handing back control. The ramp never steps down while braking, so a
    release and re-engage doesn't drop the brake. A zero-initialised state is
    engaged, and a corrupted mode or ramp brakes at the full target.
    Values are named TBC constants: 5 m/s^2 (ADR-0012, ADR-0052), a 150 ms
    ramp (ADR-0012). The brake current for that deceleration, ~8 A, is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
2026-11-05 feat(vesc): run the e-stop brake routine on the controller (#80)
    port/estop_vesc.c reads ESTOP on the Servo/PPM pin (PB6 on the A50S,
    ICD-corner-connector) with the internal pull-down, steps the routine
    every millisecond and applies its brake current straight to the motor.
    It takes the pin back if the PPM app or servo output reconfigures it,
    and doesn't brake while upstream holds the motor off after a fault.
    Hooks in bldc/, each marked ARC (ADR-0037):
    - main.c starts it right after mc_interface_init(), before CAN, USB or
    apps can send commands;
    - mc_interface_try_input(), which every motor setter calls, ignores
    commands while it brakes (CAN, USB, apps and upstream's timeout);
    - timeout_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
2026-11-05 docs(vesc): warn that e-stop release relies on the sync MCU latch (#80)
    The routine hands control back on the first command after a release.
    That is only safe once the sync MCU latches on every e-stop press and
    resumes only after the release, its power-on checks and the operator's
    re-arm, with zero commands first (owner decision, ADR in draft). Until
    then a bench rig resumes on the next command, so the README says to test
    with the wheel off the ground and the command source at zero.
2026-11-05 test(vesc): never compile the e-stop suite's asserts out (#80)
    test_estop.c and test_stubs.c check with assert(), so a build with NDEBUG
    (CMAKE_BUILD_TYPE=Release) would run them with every check removed and
    pass. They now undefine NDEBUG before including assert.h.
2026-11-05 test(vesc): check the e-stop routine exhaustively and against its sources (#80)
    Written from ADR-0012, ADR-0034 and estop.h rather than from estop.c, so
    they hold whatever the implementation looks like:
    - test_estop_props.c steps every sequence of line and command over 11
    steps from power on (4.2 million), and checks each step: a low line
    brakes and blocks in the same step; only a release followed by a
    command in a later step drives, and it always does; the brake current
    follows the 150 ms ramp, never drops while braking and never exceeds
    the target. Also long random runs, odd step times (NaN, infinite,
    negative count as 0), every corrupted mode and ramp, and the brake
    current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
2026-11-05 test(vesc): check the e-stop's T and brake mass against ADR-0057 (#80)
    T is now 2.8 s and the brake current is sized for a 5 kg car (ADR-0057). The check reads both from ADR-0057 rather than ADR-0012's status line, which still quotes the old 2.4 s.
2026-11-05 docs(vesc): cite ADR-0057 for the e-stop's brake mass (#80)
2026-11-05 feat(vesc): brake on command loss, on the e-stop ramp (ADR-0035, #120)
    While driving, no command for 150 ms (TBC, ADR-0035) brakes on the same
    ramp as the e-stop and ignores commands until a fresh one arrives. A
    press takes over at any time and keeps the brake applied. It replaces
    upstream's timeout (1000 ms, then coasting), which can't act while the
    routine brakes. arc_estop_command_timeout() is the COMMAND_TIMEOUT bit
    for the telemetry (#81).
    A command is anything that resets upstream's timeout, as for a release:
    CAN on the car, and on a bench also USB and VESC Tool's keepalive.
    The exhaustive model learns the timeout and walks every sequence again
    at 40 ms steps, so it fires and clears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
2026-11-05 docs(systems): write the procedure for flashing the motor controllers (#181)
    How our VESC firmware goes onto the four installed A50S controllers: the
    build from main, the car on a stand, the configuration backed up, one
    controller at a time, and the e-stop, speed cap and command timeout
    checked again after each. And how a controller that no longer takes
    uploads is recovered over SWD (RSK-20).
    A draft: not yet followed on hardware. The power arrangement on the car
    and the exact SWD command are TBD, to be settled when SWD recovery is
    first shown on a spare (the arrival procedure).
2026-11-05 docs(systems): disconnect VESC Tool for the e-stop release check (#181)
    Its keepalive counts as a fresh command, so with VESC Tool connected the brake lets go on release and the check fails for the wrong reason.
2026-11-10 Yufeng/simulator (#228)
    * feat(sim + ground station): foundation of ground station and sim set up
    * feat(ground-station): redesigned ui and added popups for more data
    * feat(ground-station): mvp complete, will need to incorporate more sensor data later
    * feat(simulator and ground station): added lidar sensor
    * feat(ground station + simulator): imu sensor added
    * feat(simulator): add E-22 wheel encoder with noise relay
    JointStatePublisher feeds the four wheel joint angles every 1 ms to
    wheel_encoder_noise.py, which applies nonlinearity and jitter, wraps,
    quantizes to 14 bits and publishes /encoders/wheel, one JointState per
    sensor carrying ARC_ANGLE_SAMPLE's fields. Failed reads are dro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
