Autonomous-Robotics-Carleton/arc-monorepo/(notices)

Notices in the files:
README.md:
License: MIT
